jraben/truck-assistant/docs/ev-features.md

# EV in-car display features: wish-list for a DIY Slate dashboard

Researched 2026-11-05. The target build is a touchscreen computer (Pi 5, an N100 mini-PC or an Android head unit) running CarPlay through a Carlinkit dongle, with GPS, add-on cameras, aux relays, a Home Assistant link, and possibly read-only CAN.

## What the Slate gives us (baseline)

- No infotainment screen. A phone mount comes standard, with an optional tablet mount, plus a small driver display, physical HVAC knobs and USB power. ([The Drive](https://www.thedrive.com/news/less-is-more-slate-brings-back-window-cranks-hvac-knobs-and-a-screenless-dash), [Jalopnik](https://www.jalopnik.com/1843154/slate-auto-electric-truck-suv-customizable-design-specs-details/), [Edmunds](https://www.edmunds.com/slate/))
- **No built-in modem.** OTA updates and the Slate app go through your phone. ([Guessing Headlights](https://guessingheadlights.com/?p=1472131), [inkl](https://www.inkl.com/news/slate-s-affordable-ev-truck-has-no-screens-uses-your-phone-for-updates), [TechMyMoney](https://techmymoney.com/2026/09/01/slate-truck-skips-built-in-infotainment-for-your-phone/?amp=1))
- **CAN/OBD access is undocumented.** Forum posts claim Slate said it uses CAN, but I could not confirm that, and no pinout or third-party access policy has been published. Every "NEEDS TRUCK DATA" row below depends on this. ([Slate Forums thread](https://www.slateforums.com/forum/goto/post?id=221167), [AutoGuide on the open accessory platform](https://www.autoguide.com/auto/category/trucks/2027-slate-truck-is-an-open-source-pickup-44619247))
- **Consequence:** SoC, speed, gear, TPMS, motor and battery temperatures, and charging state cannot be read until CAN is confirmed. Without it, we approximate from GPS, an IMU, our own sensors and the Slate phone app (which may offer no API).

### Feasibility key
- **EASY:** software and screen only.
- **NEEDS HARDWARE:** add-on part, with a rough cost.
- **NEEDS TRUCK DATA:** needs CAN or OBD reads, which are unknown on Slate.
- **NOT FEASIBLE:** with the reason.

"Connectivity" means the phone hotspot while driving and home Wi-Fi in the garage. A dedicated LTE modem or hotspot (about $60–150 plus a plan) makes the HA link always-on.

## Feature table

| Feature | Who has it | Slate DIY feasibility | How we'd do it |
|---|---|---|---|
| Charging-aware route planning with arrival SoC | Tesla Trip Planner + Set Arrival Energy ([Basenor](https://www.basenor.com/blogs/news/teslas-set-arrival-energy-feature-is-coming-to-the-app)); Polestar/Volvo Google Maps with SoC target ([Polestar](https://www.polestar.com/us/news/google-maps-guide)); Hyundai/Kia ccNC auto-adds up to 4 stops (EV9, Kona) ([forum](https://www.insideevsforum.com/community/threads/hyundai-kia-navigation-is-gaining-ev-route-planning-functionality-soon.15697)); Rivian, Lucid, Ford, GM native nav | **EASY** with manual SoC entry; **NEEDS TRUCK DATA** for live SoC | ABRP in CarPlay (ABRP supports CarPlay), with SoC typed in or pulled from CAN later |
| Battery preconditioning for DC fast charging | Tesla, Polestar (auto when navigating to a DCFC) ([Polestar manual](https://www.polestar.com/uk/manual/polestar-2/2023/article/1e2c80dd24931039c0a801510d8092e4/)), Rivian, Hyundai/Kia, Ford, GM, Lucid | **NOT FEASIBLE** unless Slate exposes it (it would need CAN *write*, which is out of scope) | Show a "Slate app: precondition?" reminder when the destination is a charger |
| Cabin pre-cool (remote climate) | All of them via their apps | **NEEDS TRUCK DATA / NOT FEASIBLE** for the factory HVAC (knobs); **NEEDS HARDWARE** for a workaround | A relay-driven 12V vent fan, or a sunshade reminder. Real pre-cool depends on Slate's app |
| Energy graphs / consumption app | Tesla Energy app with per-trip graphs ([Not a Tesla App](https://www.notateslaapp.com/news/4005/tesla-updates-energy-app-in-spring-update-202614-custom-trips-pause-and-new-widgets)); Rivian, Ford, Hyundai, Lucid efficiency screens | **NEEDS TRUCK DATA** (kWh); **NEEDS HARDWARE** for an alternative: a 12V/HV shunt is not practical | Log Wh/mi from CAN SoC delta × pack size against GPS distance, and chart it like Tesla's 200-mi graph |
| Trip computer (distance, time, avg speed, elevation) | Everyone | **EASY** (GPS) | GPS track logger with A/B trips, elevation gain/loss, and nightly sync to HA/NAS |
| Sentry / Gear Guard parked camera security | Tesla Sentry ([Engadget](https://www.engadget.com/2019/02/14/tesla-sentry-dog-dashcam-autopilot/)); Rivian Gear Guard with app alerts ([Rivian camping story](https://rivian.com/stories/software-update-camping)); GM/Ford app alerts | **NEEDS HARDWARE**: 2–4 cams ($30–80 each), PIR/radar sensor ($10), low-power standby, LTE for remote alerts | Frigate-style motion detection on the head unit or a low-power SBC, pushed through HA/phone push. Watch the 12V drain |
| Dashcam (rolling loop + save clip) | Tesla (now up to 24h retention per 2026 reports) ([Not a Tesla App](https://www.notateslaapp.com/news/700/the-top-features-in-any-tesla)); Rivian Gear Guard drive recording; Hyundai/Kia built-in cam (some trims) | **NEEDS HARDWARE**: front/rear USB or AHD cams ($60–150) + 256 GB+ SSD ($30) | ffmpeg segment loop, a SAVE button on screen plus a G-sensor trigger from the IMU, and Wi-Fi offload to the NAS at home |
| 360° / bird's-eye camera | Rivian, Ford Lightning, GM, Hyundai/Kia, Lucid, Polestar, Mach-E | **NEEDS HARDWARE**: 4 fisheye cams + stitching box ($200–450 kits), or DIY stitch with OpenCV | Buy an aftermarket 360 kit with composite/AHD output into a capture card. DIY stitching is a stretch goal |
| Trailer camera / transparent trailer | GM Silverado EV transparent trailer and length detection via OTA ([EV Magz](https://evmagz.com/gm-rolls-out-major-software-update-for-silverado-ev-and-sierra-ev-pickups/)); Ford Lightning; Rivian | **NEEDS HARDWARE**: wireless trailer cam ($80–200) | Auto-show the trailer cam on reverse/turn signal (needs a trigger wire or CAN). Transparent overlay is hard, so skip it |
| Hitch assist / hitch guide lines | Ford Pro Trailer Hitch Assist auto-steers ([InsideEVs](https://insideevs.com/news/661483/ford-pro-trailer-hitch-assist-artificial-intelligence/about:blank)); GM, Rivian guide lines | Guide lines: **NEEDS HARDWARE** (a rear cam pointed at the ball, $40). Auto-steer: **NOT FEASIBLE** (needs steering control) | Overlay a static hitch-ball target and dynamic distance lines on the rear cam |
| Onboard scales / payload | Ford F-150/Lightning on-board scales + Smart Hitch tongue weight ([Design News](https://www.designnews.com/automotive-engineering/ford-weighs-advantages-built-scales-2021-f-150)) | **NEEDS HARDWARE**: ride-height sensors ($50–150, calibrated) or a weigh-safe hitch ball ($200+) | Rear-axle ultrasonic/laser height sensor calibrated against CAT-scale readings to give estimated payload |
| Pro Power Onboard / outlet & V2L control | Ford Lightning Pro Power (2.4/9.6 kW); Hyundai/Kia V2L with a minimum-SoC cutoff in settings ([Lectron](https://ev-lectron.com/en-ca/blogs/blog/how-to-use-the-v2l-feature-of-the-hyundai-ioniq-5-with-the-lectron-v2l-adapter)); Rivian outlets, Silverado EV PowerBase, Tesla Cybertruck | Factory outlet: depends on whether Slate offers one (**NEEDS TRUCK DATA**). Aux power: **NEEDS HARDWARE**, a 12V inverter or a portable power station ($300–900) | Relay-switch an inverter, add a power-station BLE/HA integration, and enforce a "don't drain 12V below X" cutoff |
| Aux relay / upfitter switches | Ford upfitter switches, Rivian/GM accessory power controls | **NEEDS HARDWARE**: 4–8 ch relay board or ESPHome/Shelly 12V ($20–60) | On-screen buttons for light bar, bed lights, compressor and fridge. Each one is an HA entity too |
| Tow mode & trailer profiles | GM Trailering app (profiles, checklists, maintenance, theft alerts) ([Chevrolet](https://www.chevrolet.com/electric/silverado-ev/intuitive-technology)); Rivian tow mode in off-road modes ([Green Car Reports](https://www.greencarreports.com/news/1141137_rivian-evs-software-update-makes-towing-an-all-terrain-experience)); Ford | Profiles/checklist: **EASY**. Range-while-towing correction: **NEEDS TRUCK DATA** for accuracy | Per-trailer profile (weight, length, tire PSI, pre-trip checklist) that applies a range multiplier to the route plan |
| Camp mode | Tesla Camp Mode ([dubizzle](https://www.dubizzle.com/blog/cars/tesla-camp-mode/)); Rivian Camp Mode with leveling, outlet timers, display off, "camp courtesy" ([CleanTechnica](https://cleantechnica.com/2022/08/31/rivians-new-camp-mode-levels-your-truck-helps-in-other-ways/)); Hyundai Utility Mode ([AutoRoamer](https://www.autoroamer.com/posts/hyundai-ioniq-5-camping-guide.html)) | **EASY** for software; **NEEDS HARDWARE** for an IMU ($10) + relays | One tap: dim/blank the screen, turn bed lights and fridge on, show a level bubble from the IMU, run a 12V drain timer and silence chimes |
| Pet / dog mode | Tesla Dog Mode; Rivian Pet Comfort with on-screen message ([Drive Tesla](https://driveteslacanada.ca/?p=53827)); Hyundai/Kia, Ford | Display + sensor: **NEEDS HARDWARE** (cabin temp sensor $5–15). Holding A/C: **NEEDS TRUCK DATA** (it would need Slate HVAC to run while parked) | Full-screen "Dog is fine, it's 74°F inside" plus a cabin-temperature push to the phone via HA. Phoenix: alert at >85°F |
| Cabin overheat protection / cabin temp alert | Tesla Cabin Overheat Protection; Rivian | **NEEDS HARDWARE**: temp sensor ($5) + LTE for alerts | HA automation: cabin >120°F gives a phone push, and a relay can run a vent fan. A child/pet-left-behind reminder via seat or PIR sensor |
| Games while parked | Tesla Arcade with BT controllers ([Not a Tesla App](https://www.notateslaapp.com/news/700/the-top-features-in-any-tesla)); Polestar/Volvo and GM via Google Play; Rivian | **EASY** (Android/Linux apps, Moonlight game stream from the house) | Parked-only launcher tile gated on GPS speed = 0 and park |
| Theater / streaming while parked | Tesla Theater ([Not a Tesla App](https://www.notateslaapp.com/news/700/the-top-features-in-any-tesla)); Ford (YouTube, karaoke) ([Benzinga](https://benzinga.com/z/40920761)); GM/Polestar Google Play; Rivian, Lucid, Hyundai/Kia (some trims) | **EASY** (needs Wi-Fi or a hotspot) | Plex/Jellyfin from the NAS (pre-download for offline), YouTube. Lock out while moving |
| Karaoke | Ford Lightning/Mach-E Connectivity package ([Benzinga](https://benzinga.com/z/40920761)); Tesla Caraoke | **EASY** (an app); a mic adds **NEEDS HARDWARE** ($20) | Low priority. A browser karaoke page or a Jellyfin lyrics overlay |
| Web browser | Tesla, Rivian, Lucid; GM/Polestar via apps | **EASY** | Chromium kiosk tab, parked only |
| Voice assistant | Polestar/Volvo/GM Google Assistant or Gemini ([Polestar](https://www.polestar.com/en-ca/polestar-4/technology/)); Ford Alexa ([Benzinga](https://benzinga.com/z/40920761)); Tesla, Rivian, Lucid (Alexa), Hyundai/Kia native | **EASY**: Siri through CarPlay for free; a WOPR/HA assist voice needs a mic ($20) | Wake word gives HA Assist / WOPR ("open the garage", "is the back door locked", "what's the gate code here") |
| Driver profiles | Tesla, Rivian, Lucid, Polestar, Ford, GM, Hyundai/Kia (seat, mirrors, climate, nav favorites) | Screen prefs: **EASY**. Seat/mirror memory: **NOT FEASIBLE** (Slate has manual seats and crank-style basics) | Profile picks the layout, favorites, CarPlay phone and EQ. Auto-select by which phone's BT connects |
| Light shows / easter eggs | Tesla Light Show (Toybox, custom USB shows) ([Not a Tesla App](https://www.notateslaapp.com/news/2422/photos-and-video-of-teslas-holiday-update-2024-part-1)); Rivian, Lucid welcome animations | Factory lights: **NOT FEASIBLE** (no CAN write). Add-on lights: **NEEDS HARDWARE**, addressable LED strips + ESP32 ($30–80) | WLED bed/rock lights synced to music, and a "welcome home" HA scene |
| Off-road screen: pitch/roll inclinometer | Rivian Gauge View with pitch/roll, torque, steering angle, tire pressure ([Green Car Reports](https://www.greencarreports.com/news/1141137_rivian-evs-software-update-makes-towing-an-all-terrain-experience)); Ford, GM, Hyundai/Kia (some) | **NEEDS HARDWARE**: IMU, BNO085/MPU-6050 ($10–30) | Pitch/roll gauges with red limit lines, compass, altitude and GPS breadcrumbs for trail-back. A big win for little money |
| Tire pressure (TPMS) | Everyone (Rivian, Ford, GM show per-tire values) | **NEEDS TRUCK DATA** for factory sensors, *or* **NEEDS HARDWARE**: BLE TPMS caps/sensors ($40–80) | BLE TPMS decoded in software, with per-tire PSI and temperature (Phoenix pavement heat) and alerts |
| Scheduled charging / TOU rates | Tesla, Rivian, Ford, GM, Hyundai/Kia, Polestar (in car + app) | Truck-side: **NEEDS TRUCK DATA / Slate app**. EVSE-side: **EASY** if the home charger is in HA | Schedule the *charger* from HA (SRP/APS off-peak windows) and show "charging starts 9 pm" on the dash |
| Remote app (status, lock, climate) | All OEMs | Status: **NEEDS HARDWARE** (always-on LTE + low-power monitor). Lock/climate: **NOT FEASIBLE** without CAN write | The HA dashboard becomes the "truck app": GPS location, cabin temp, 12V voltage, camera snapshot, relay control |
| GPS tracking / geofence | All OEM apps | **NEEDS HARDWARE**: GPS (already planned) + LTE for live tracking | Truck device tracker in HA. Geofence triggers the garage door and the "arrived at a job site" gate code (WOPR /api/where) |
| OTA updates | Tesla, Rivian, Lucid, Polestar, GM, Ford Power-Up, Hyundai/Kia. Slate does OTA through the phone ([inkl](https://www.inkl.com/news/slate-s-affordable-ev-truck-has-no-screens-uses-your-phone-for-updates)) | **EASY** for our own software | Head unit pulls its own update from GitHub/NAS when on home Wi-Fi, with A/B rollback. Slate's own OTA stays on the phone |
| Home Assistant / smart home integration | Rivian, Tesla, Ford via 3rd-party HA integrations; Google built-in (Polestar/GM) smart-home control | **EASY** (the main differentiator here) | Garage, gate, alarm, front-door cam on the dash, HA presence, and "leaving home" checks (doors locked? oven off?) |
| Phone as key / walk-away lock | Tesla, Rivian, Ford Mach-E, Hyundai/Kia digital key | **NOT FEASIBLE** (needs body-control integration) | Skip. At most a walk-away reminder: phone BT drops while the truck is unlocked |
| 12V battery monitor | Rare on screen (Rivian shows 12V faults) | **NEEDS HARDWARE**: voltage divider/INA226 ($5–15) | Show 12V volts, auto-shutdown the head unit below 12.1V, and alert via HA |
| Charging station finder + live availability | Everyone native; Slate app does charger search ([inkl](https://www.inkl.com/news/slate-s-affordable-ev-truck-has-no-screens-uses-your-phone-for-updates)) | **EASY** via CarPlay (PlugShare, ChargePoint, ABRP) | CarPlay apps, plus a "nearest DCFC / mi of range left" widget once SoC is known |
| Speed-limit / ADAS display | Tesla, Ford BlueCruise, GM Super Cruise, Hyundai/Kia HDA | Display: **EASY** (from CarPlay maps). ADAS: **NOT FEASIBLE** | Leave it to Waze/Apple Maps in CarPlay |

## Top 10 to steal (ranked for a Phoenix owner who runs Home Assistant)

1. **Cabin heat alarm + pet/kid screen**: cabin temp push via HA, a "dog is fine, 74°F" screen and a vent-fan relay. *NEEDS HARDWARE* (~$20 sensor, LTE for remote alerts). Holding A/C needs truck data.
2. **HA command center on the dash**: garage/gate, house cams, "leaving home" checks, gate code on arrival (WOPR). *EASY*.
3. **Dashcam + parked Sentry**: loop recording, on-screen SAVE, motion alert to the phone. *NEEDS HARDWARE* (~$150–300 cams + SSD, LTE).
4. **Charge-aware route planning (ABRP in CarPlay) with arrival SoC.** *EASY* with typed SoC, *NEEDS TRUCK DATA* for live SoC.
5. **TPMS with tire temperature** (Phoenix asphalt plus towing). *NEEDS HARDWARE* (~$50 BLE sensors).
6. **Camp mode + off-road inclinometer**: IMU level bubble, pitch/roll, screen-off, relay scenes. *NEEDS HARDWARE* (~$15 IMU + $40 relays).
7. **Aux relay / upfitter switches + power-station control** (lights, fridge, inverter, with a 12V cutoff). *NEEDS HARDWARE* (~$40–60).
8. **Scheduled off-peak charging via HA** (SRP/APS TOU) with "starts 9 pm" on the dash. *EASY* if the EVSE is in HA; truck-side *NEEDS TRUCK DATA*.
9. **Trip computer + energy/efficiency log** (GPS trips now, Wh/mi once CAN exists). *EASY* for the trip half, *NEEDS TRUCK DATA* for the energy half.
10. **Trailer profiles + trailer cam + hitch guide lines.** *EASY* for profiles; *NEEDS HARDWARE* for cams (~$40–200).

Honourable mentions: parked-only Plex/Jellyfin theater and Moonlight games (*EASY*), and WLED light show (*NEEDS HARDWARE*, ~$50).

## Caveats
- Several sources are fan sites, forums and dealer pages, so features vary by model year, trim and software version. Tesla's 24-hour dashcam retention and the Hyundai/Kia "4 auto stops" claim rest on single sources.
- Slate's CAN access is unconfirmed. Treat every NEEDS TRUCK DATA row as phase 2.
- 12V drain is the hidden cost of every "parked" feature (Sentry, camp, pet). Size a separate aux battery (LiFePO4 + DC-DC, ~$200–400) if parked features matter.
