jraben/truck-assistant/docs/brand/truck-assistant/preview.png

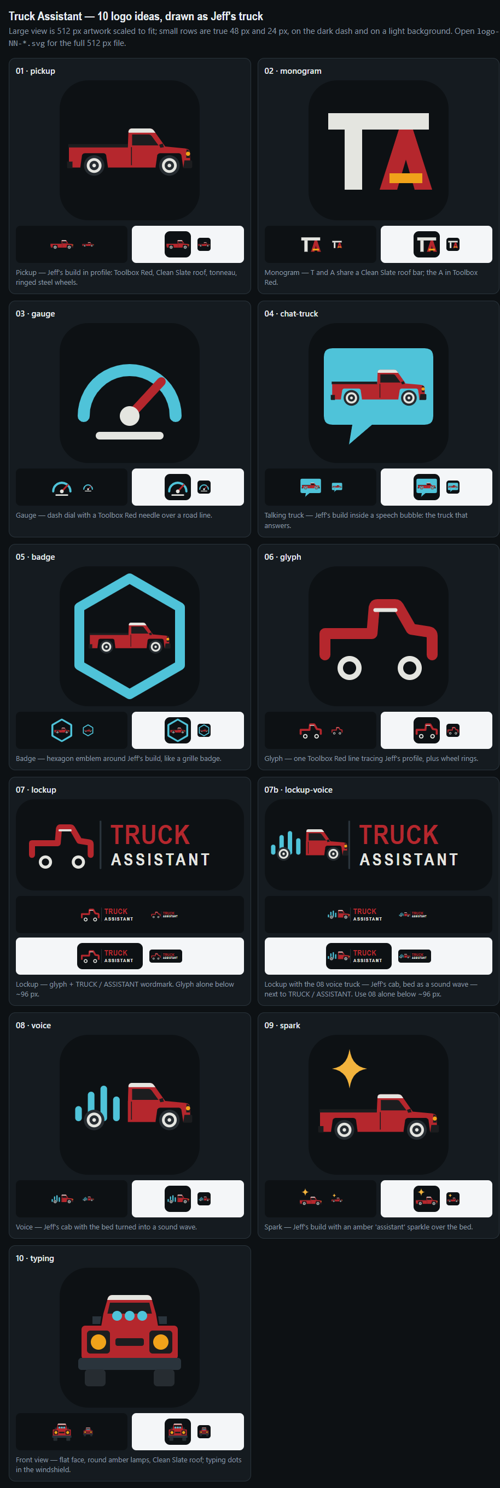
docs/brand/truck-assistant/preview.png
