jraben/truck-assistant/print/brain-enclosure/stl/logo_white.stl

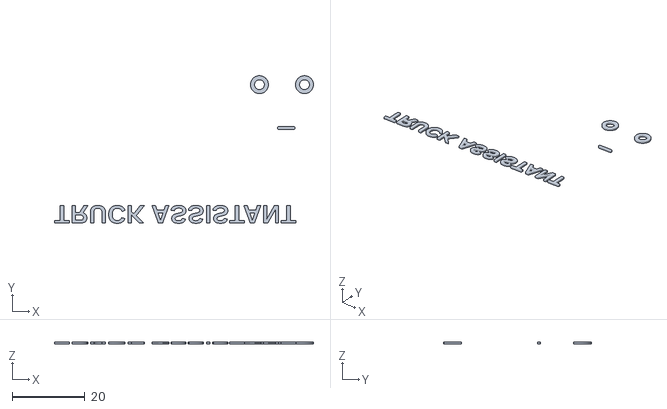
[picture p3: CAD file, 2026-11-13]
print/brain-enclosure/stl/logo_white.stl
71.0 x 40.5 x 0.6
