jraben/truck-assistant/print/cam-bracket/stl/base.stl

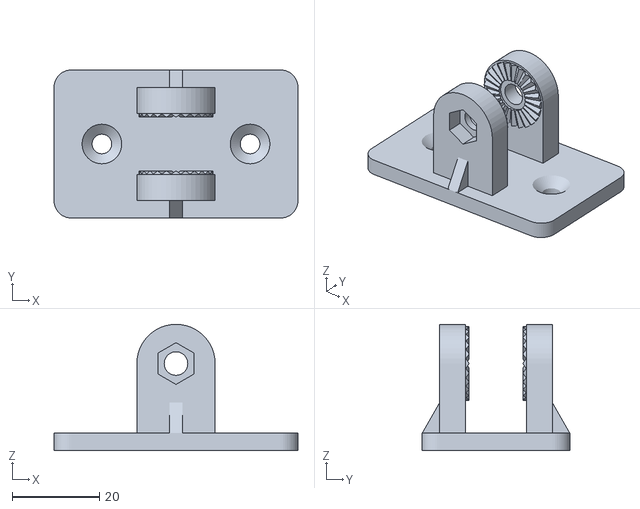
[picture p4: CAD file, 2026-11-05]
print/cam-bracket/stl/base.stl
56.0 x 34.0 x 29.0
