jraben/truck-assistant/print/dash-bar-insert/stl/hood_right.stl

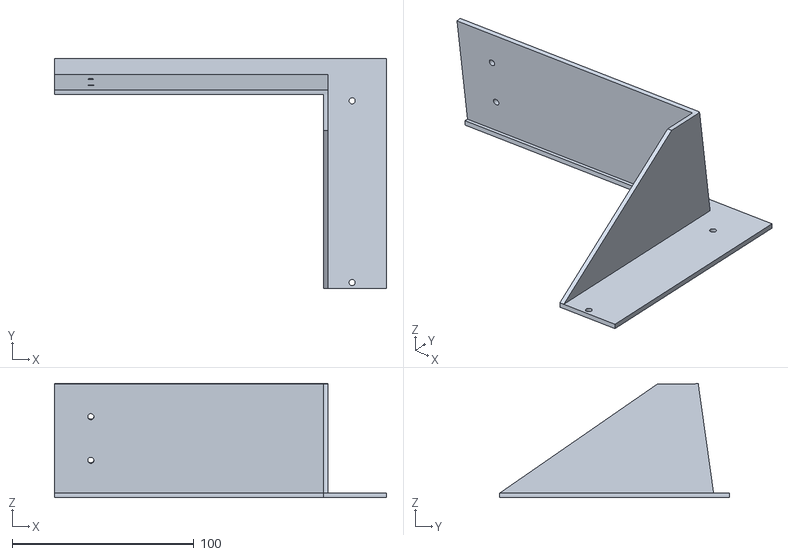
[picture p5: CAD file, 2026-11-05]
print/dash-bar-insert/stl/hood_right.stl
182.7 x 126.3 x 62.8
