jraben/truck-assistant/print/hitch-cam-mount/stl/strap.stl

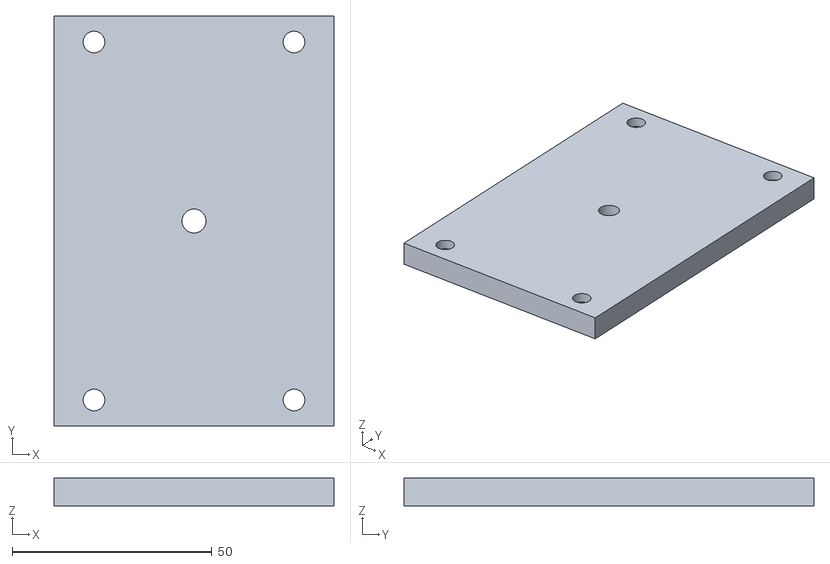
[picture p6: CAD file, 2026-11-05]
print/hitch-cam-mount/stl/strap.stl
70.0 x 102.5 x 7.00
