jraben/truck-assistant/print/service-kit/stl/loom_clip.stl

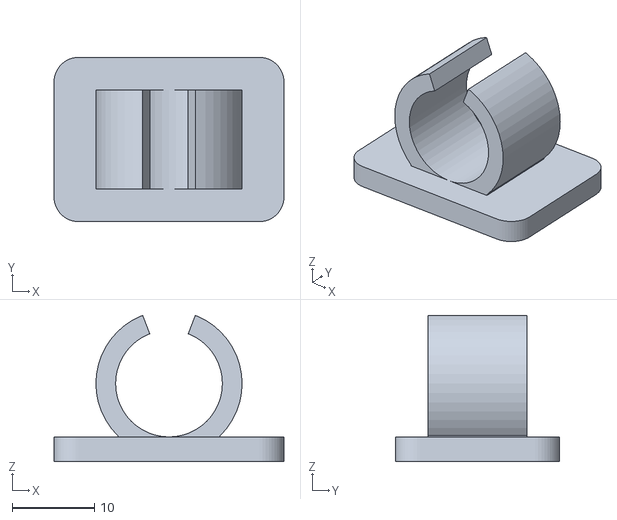
[picture p7: CAD file, 2026-11-06]
print/service-kit/stl/loom_clip.stl
28.0 x 20.0 x 17.8
