jraben/truck-assistant/print/brain-enclosure/stl/logo_red.stl

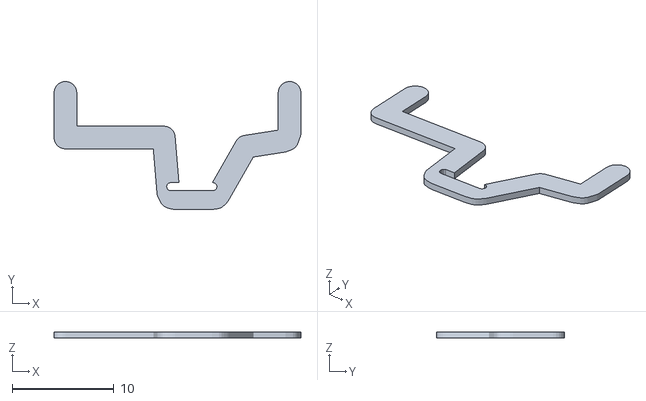
[picture p8: CAD file, 2026-11-13]
print/brain-enclosure/stl/logo_red.stl
24.2 x 12.6 x 0.6
