jraben/truck-assistant/print/cam-bracket/stl/arm.stl

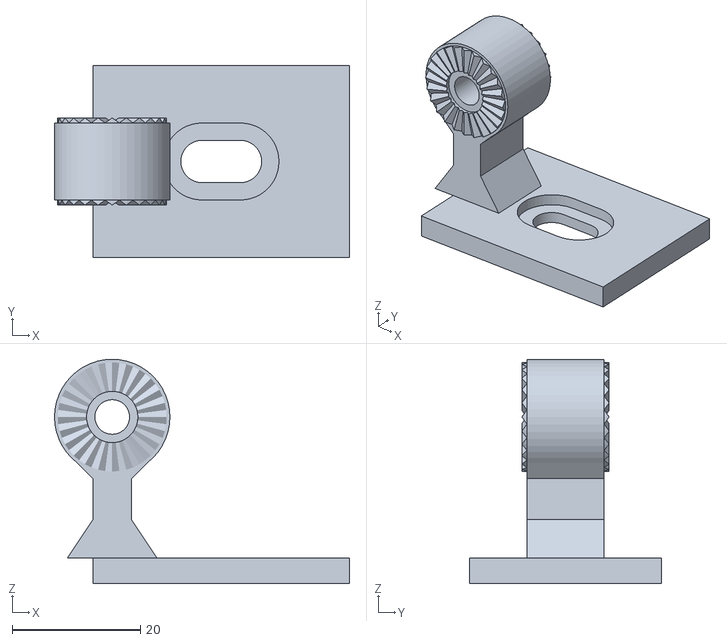
[picture p9: CAD file, 2026-11-05]
print/cam-bracket/stl/arm.stl
46.0 x 30.0 x 35.0
