jraben/truck-assistant/print/hitch-cam-mount/stl/collar.stl

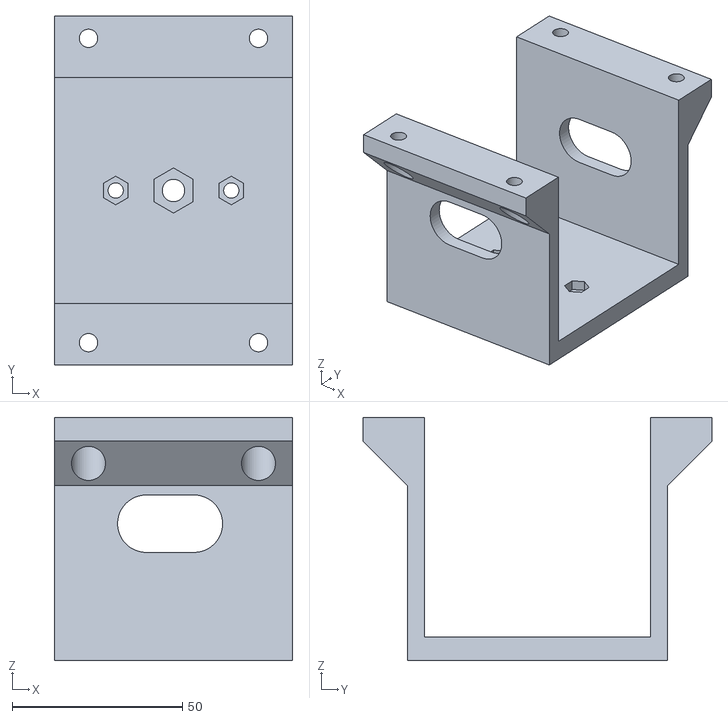
[picture p10: CAD file, 2026-11-05]
print/hitch-cam-mount/stl/collar.stl
70.0 x 102.5 x 71.5
