jraben/truck-assistant/print/service-kit/stl/dt_bracket.stl

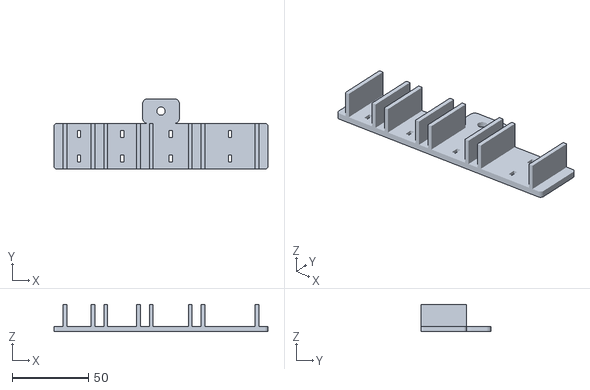
[picture p11: CAD file, 2026-11-06]
print/service-kit/stl/dt_bracket.stl
140.2 x 46.0 x 18.0
