jraben/truck-assistant/print/brain-enclosure/stl/lid.stl

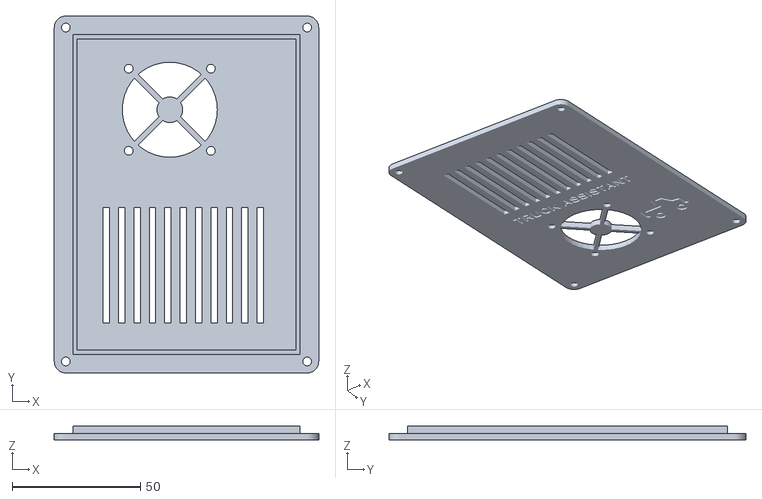
[picture p12: CAD file, 2026-11-13]
print/brain-enclosure/stl/lid.stl
103.0 x 139.0 x 5.49
