jraben/truck-assistant/print/dash-bar-insert/stl/bezel_left.stl

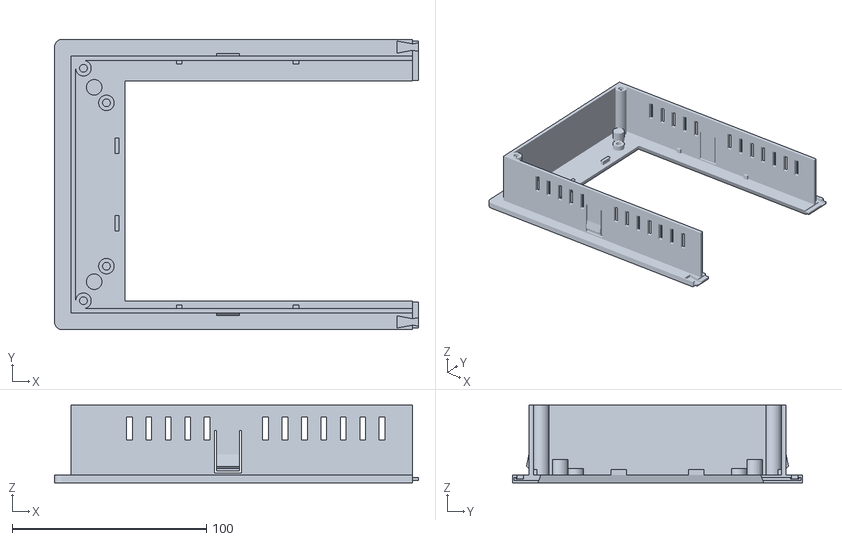
[picture p13: CAD file, 2026-11-05]
print/dash-bar-insert/stl/bezel_left.stl
187.2 x 149.3 x 40.0
