jraben/truck-assistant/print/brain-enclosure/stl/box.stl

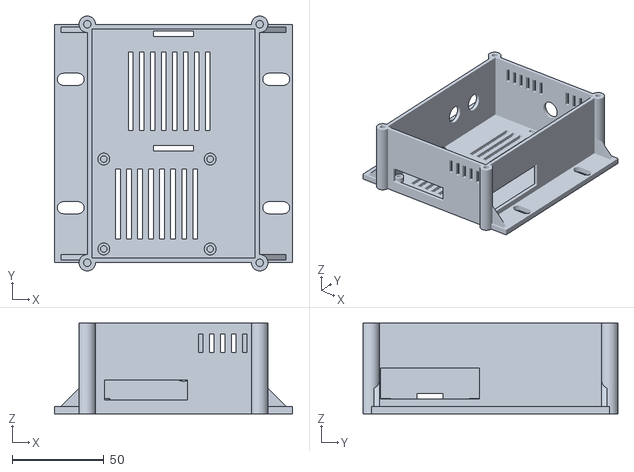
[picture p14: CAD file, 2026-11-05]
print/brain-enclosure/stl/box.stl
130.0 x 139.0 x 49.5
