jraben/truck-assistant/print/dash-bar-insert/stl/hood_splice.stl

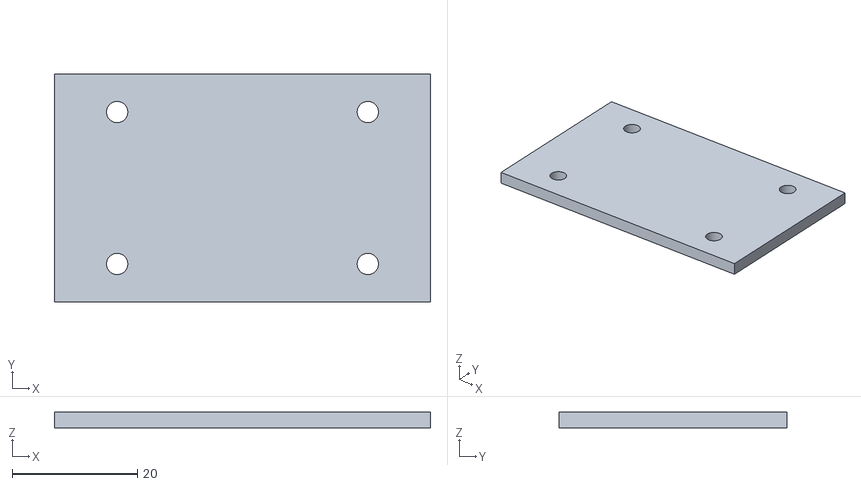
[picture p15: CAD file, 2026-11-05]
print/dash-bar-insert/stl/hood_splice.stl
60.0 x 36.4 x 2.50
