jraben/truck-assistant/print/service-kit/stl/rail.stl

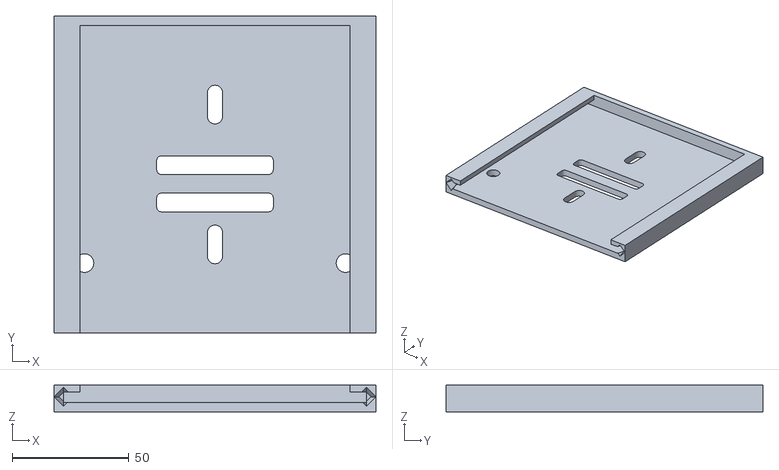
[picture p16: CAD file, 2026-11-06]
print/service-kit/stl/rail.stl
138.0 x 136.0 x 11.5
