jraben/truck-assistant/print/dash-bar-insert/stl/bezel_right.stl

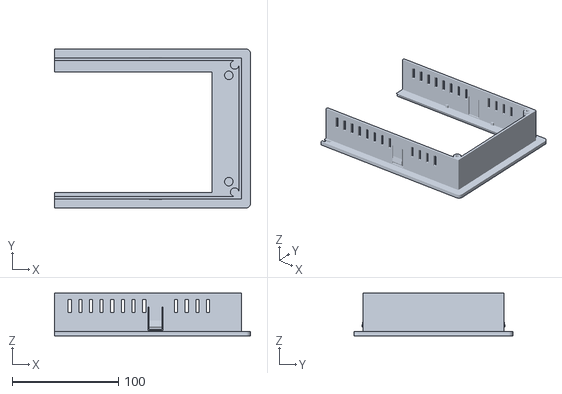
[picture p17: CAD file, 2026-11-05]
print/dash-bar-insert/stl/bezel_right.stl
184.2 x 149.3 x 40.0
