jraben/truck-assistant/print/service-kit/stl/dock.stl

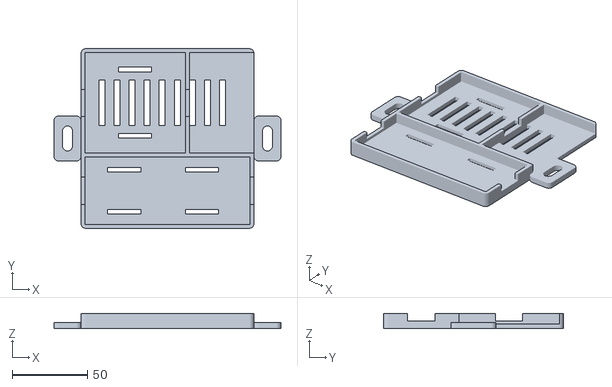
[picture p18: CAD file, 2026-11-06]
print/service-kit/stl/dock.stl
151.0 x 119.5 x 10.0
