jraben/truck-assistant/print/dash-bar-insert/stl/cover_left.stl

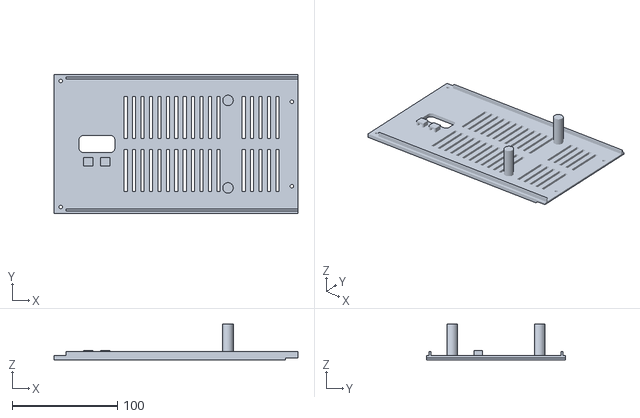
[picture p19: CAD file, 2026-11-05]
print/dash-bar-insert/stl/cover_left.stl
231.5 x 132.3 x 34.0
