jraben/truck-assistant/print/dash-bar-insert/stl/key.stl

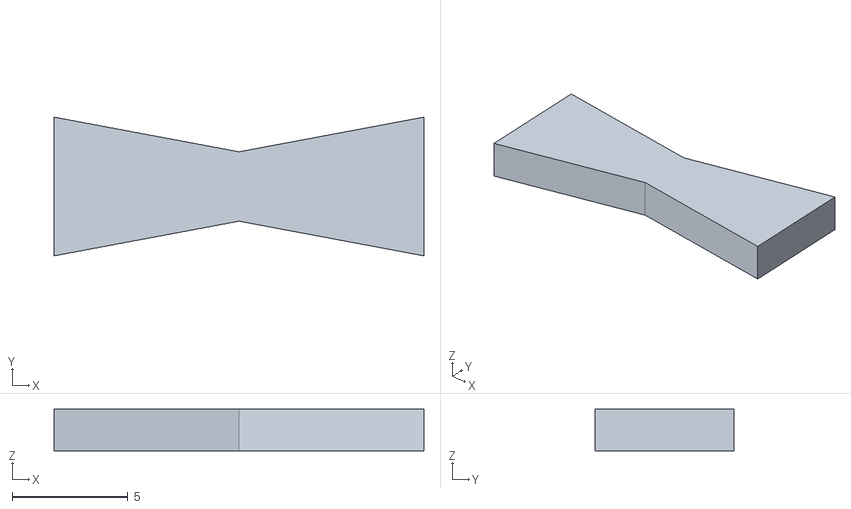
[picture p20: CAD file, 2026-11-05]
print/dash-bar-insert/stl/key.stl
16.0 x 6.00 x 1.80
