jraben/truck-assistant/print/dash-bar-insert/stl/fit_test.stl

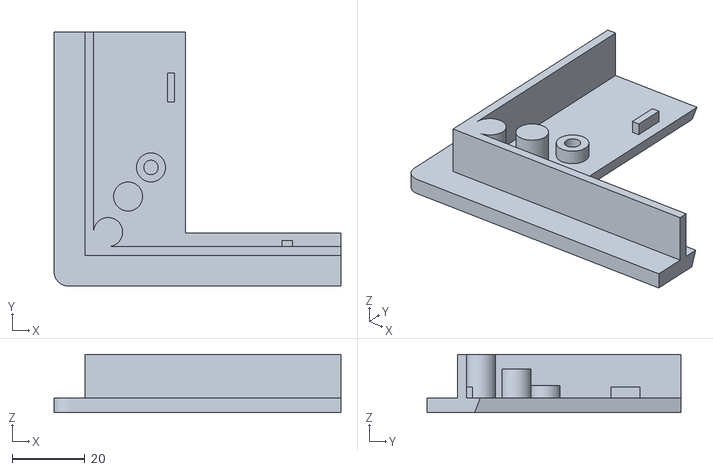
[picture p21: CAD file, 2026-11-05]
print/dash-bar-insert/stl/fit_test.stl
79.0 x 70.0 x 16.0
