jraben/truck-assistant/print/dash-bar-insert/stl/tab.stl

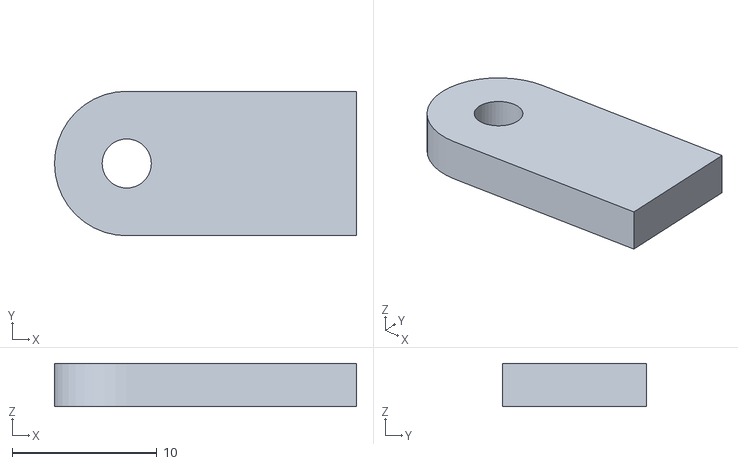
[picture p22: CAD file, 2026-11-05]
print/dash-bar-insert/stl/tab.stl
20.9 x 10.0 x 3.00
