jraben/truck-assistant/print/dash-bar-insert/stl/cover_right.stl

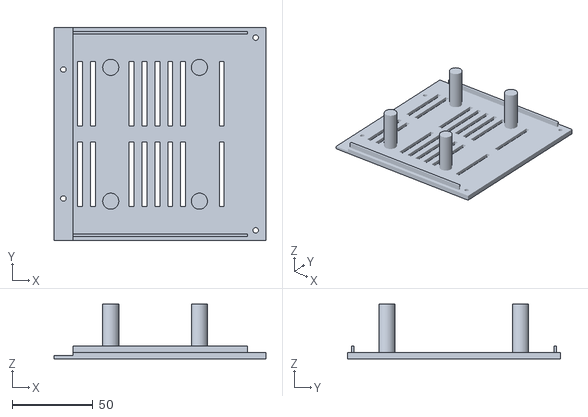
[picture p23: CAD file, 2026-11-05]
print/dash-bar-insert/stl/cover_right.stl
131.5 x 132.3 x 34.0
