jraben/truck-assistant/(list of files, cad)

Other CAD files:
print/dash-bar-insert/stl/hood_left.stl
print/service-kit/stl/loom_clip_screw.stl
