jraben/truck-assistant/print/brain-enclosure/stl/box.png

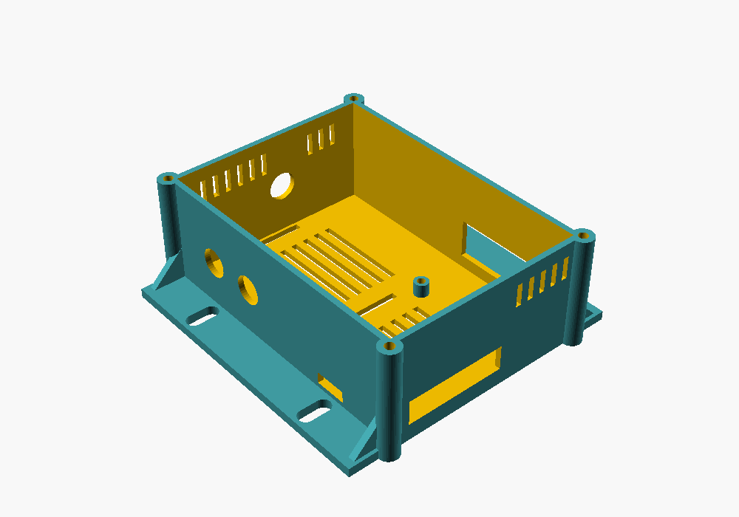
print/brain-enclosure/stl/box.png
