jraben/truck-assistant/print/brain-enclosure/stl/lid.png

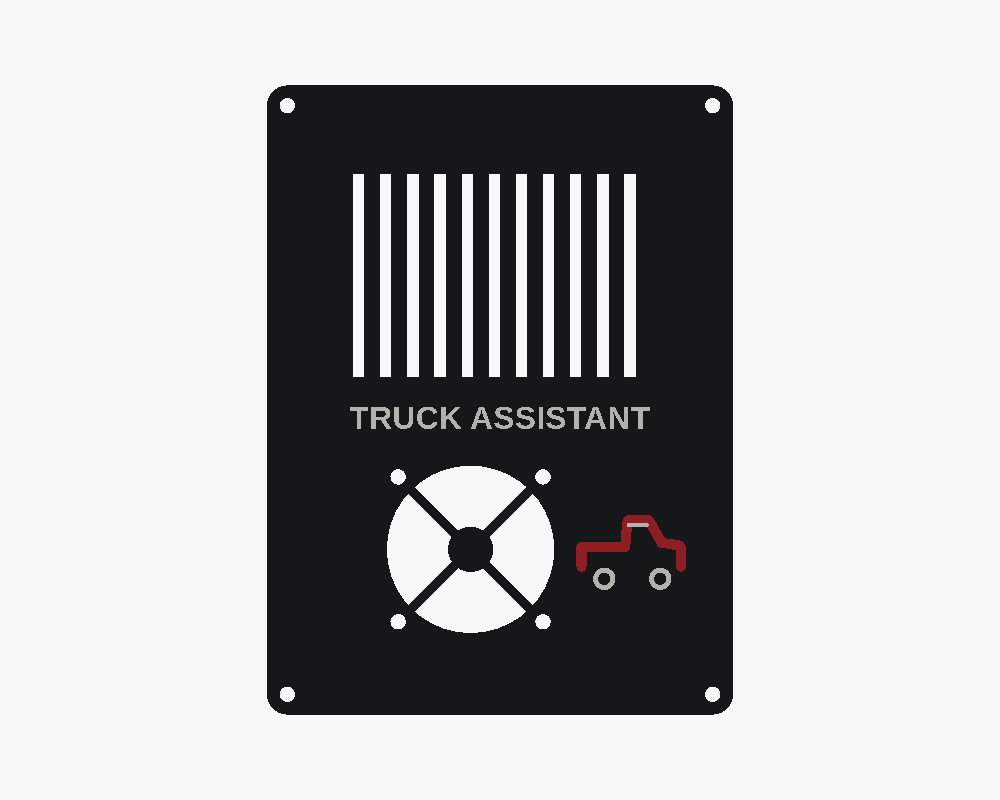
print/brain-enclosure/stl/lid.png
