jraben/truck-assistant/print/cam-bracket/stl/arm.png

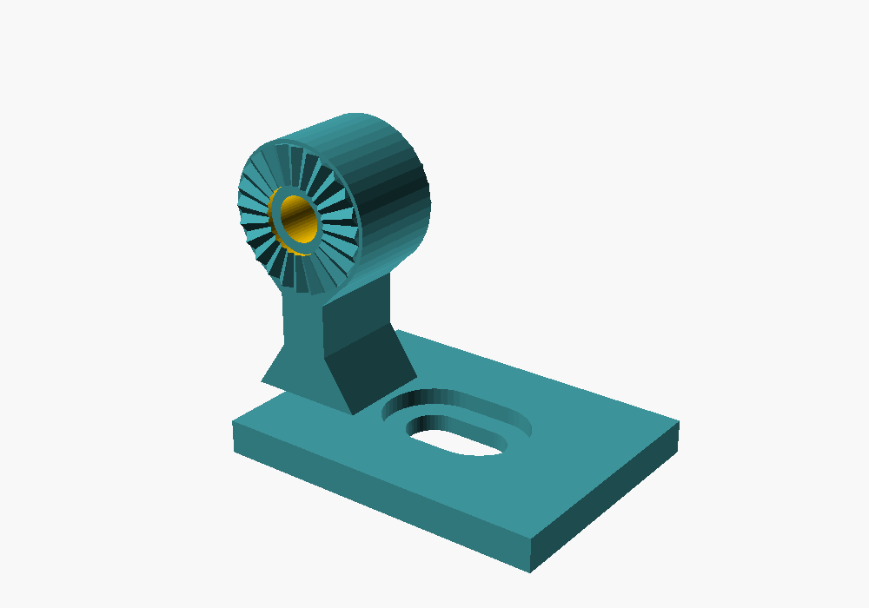
print/cam-bracket/stl/arm.png
