jraben/truck-assistant/print/cam-bracket/stl/base.png

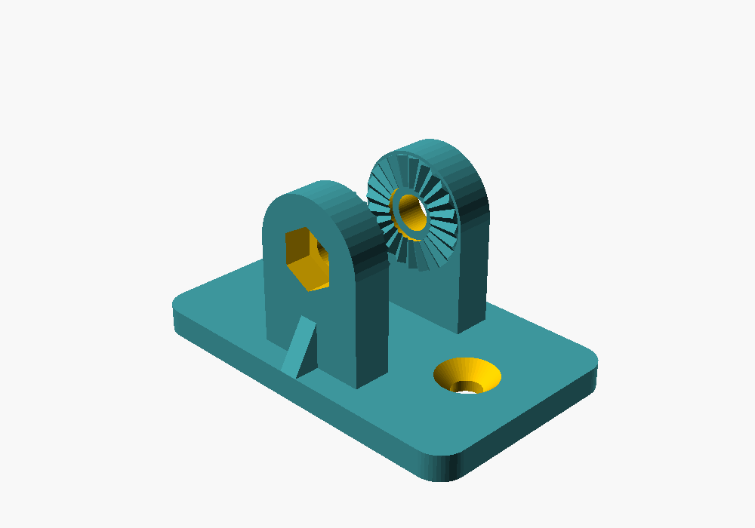
print/cam-bracket/stl/base.png
