jraben/truck-assistant/print/dash-bar-insert/stl/assembly-front.png

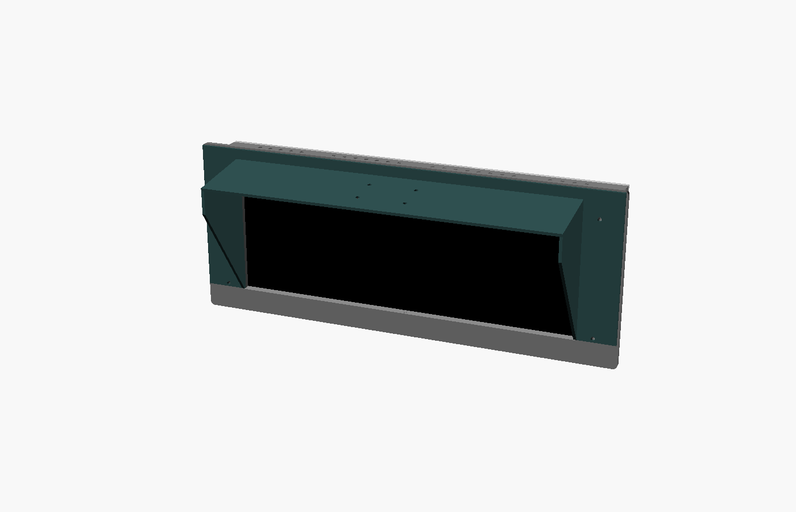
print/dash-bar-insert/stl/assembly-front.png
