jraben/truck-assistant/print/dash-bar-insert/stl/assembly-rear.png

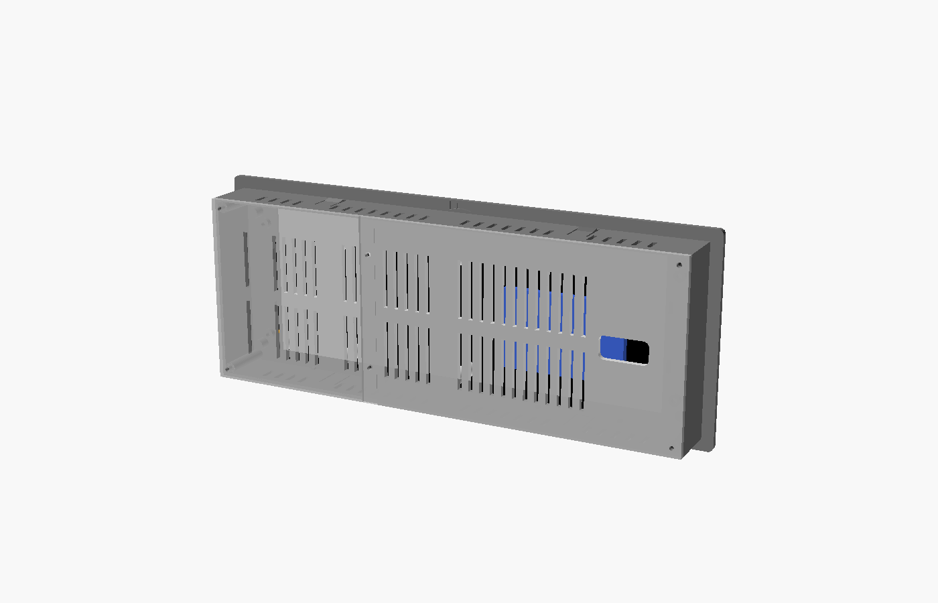
print/dash-bar-insert/stl/assembly-rear.png
