jraben/truck-assistant/print/dash-bar-insert/stl/bezel_left.png

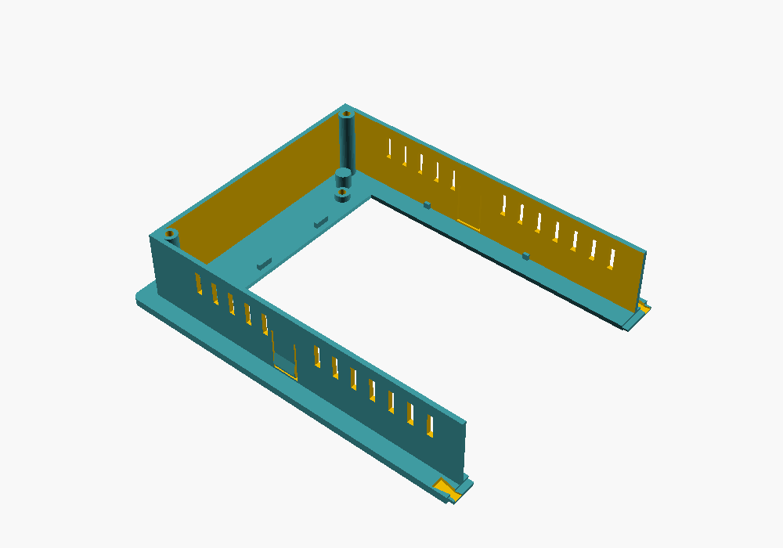
print/dash-bar-insert/stl/bezel_left.png
