jraben/truck-assistant/print/dash-bar-insert/stl/cover_left.png

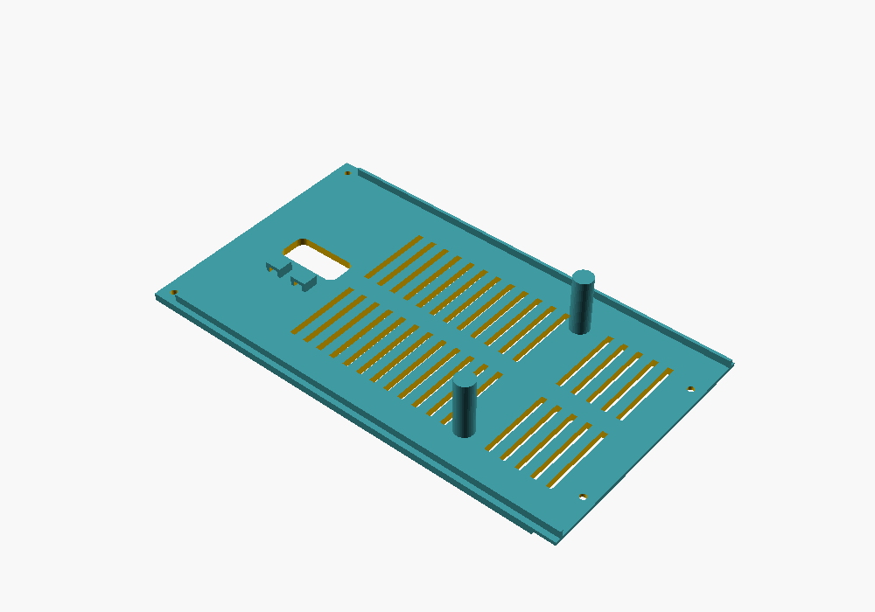
print/dash-bar-insert/stl/cover_left.png
