jraben/truck-assistant/print/dash-bar-insert/stl/hood_right.png

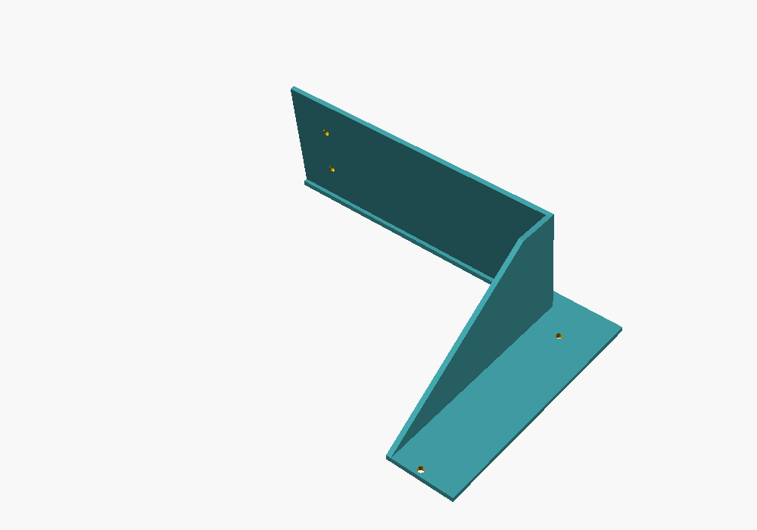
print/dash-bar-insert/stl/hood_right.png
