jraben/truck-assistant/print/hitch-cam-mount/stl/collar.png

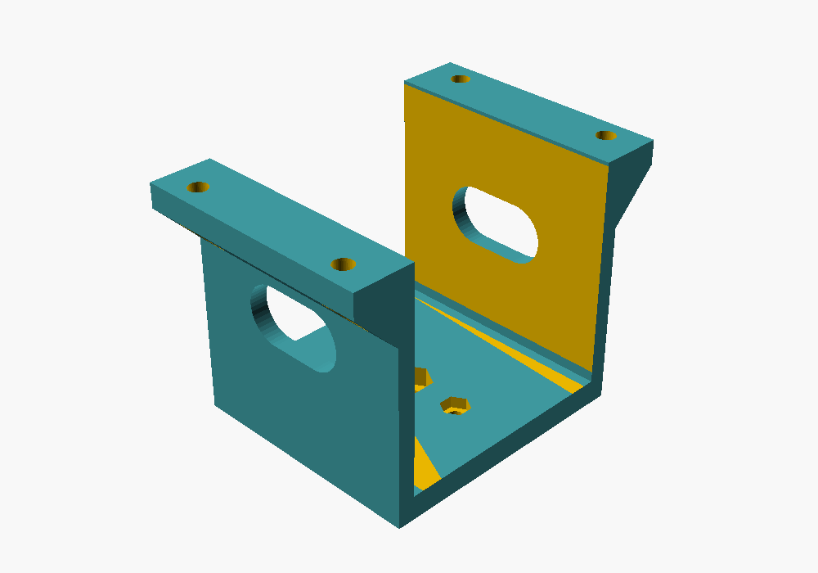
print/hitch-cam-mount/stl/collar.png
