jraben/truck-assistant/print/service-kit/stl/dock.png

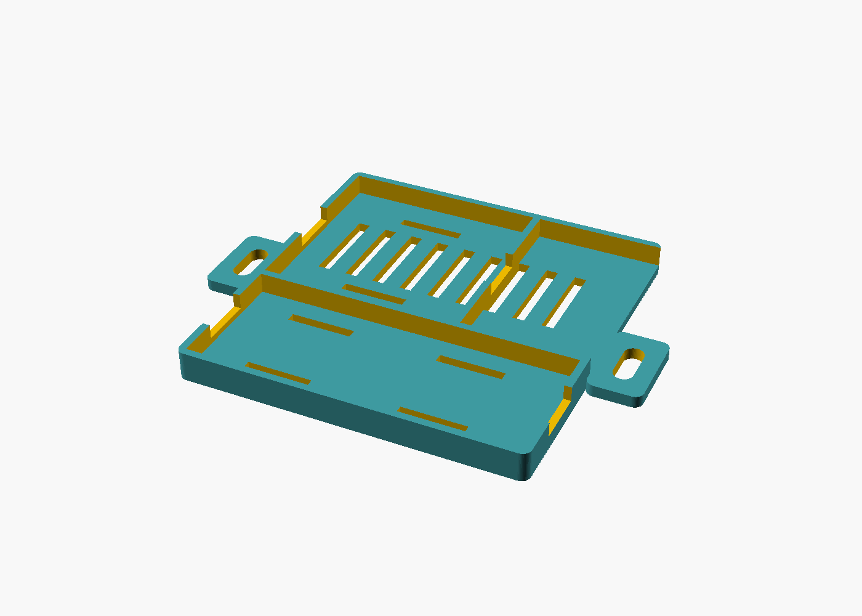
print/service-kit/stl/dock.png
