jraben/truck-assistant/print/service-kit/stl/dt_bracket.png

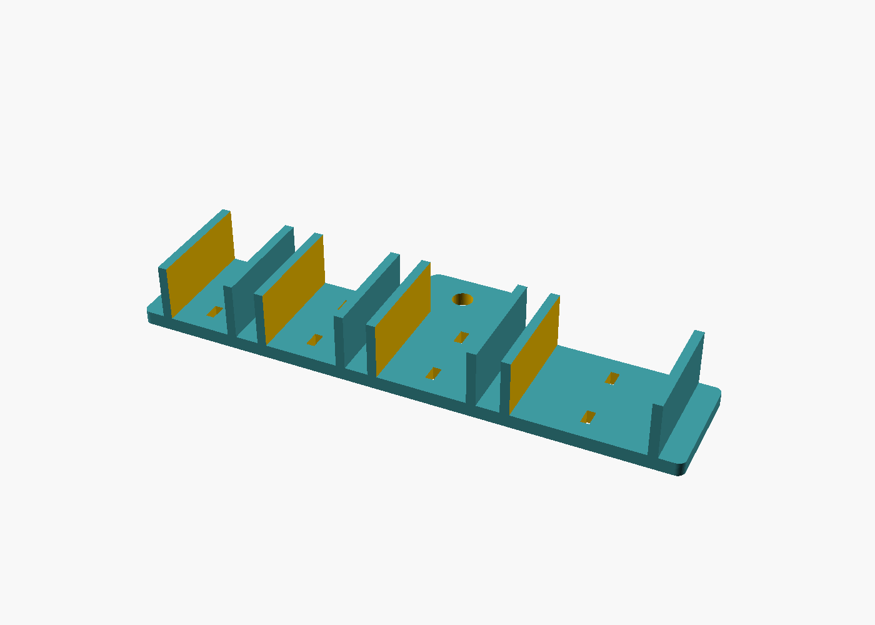
print/service-kit/stl/dt_bracket.png
