jraben/truck-assistant/print/service-kit/stl/loom_clip.png

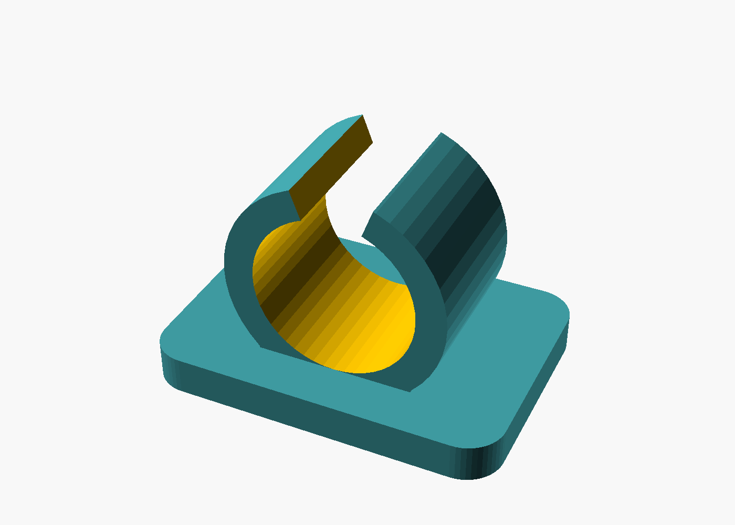
print/service-kit/stl/loom_clip.png
