jraben/truck-assistant/print/service-kit/stl/rail.png

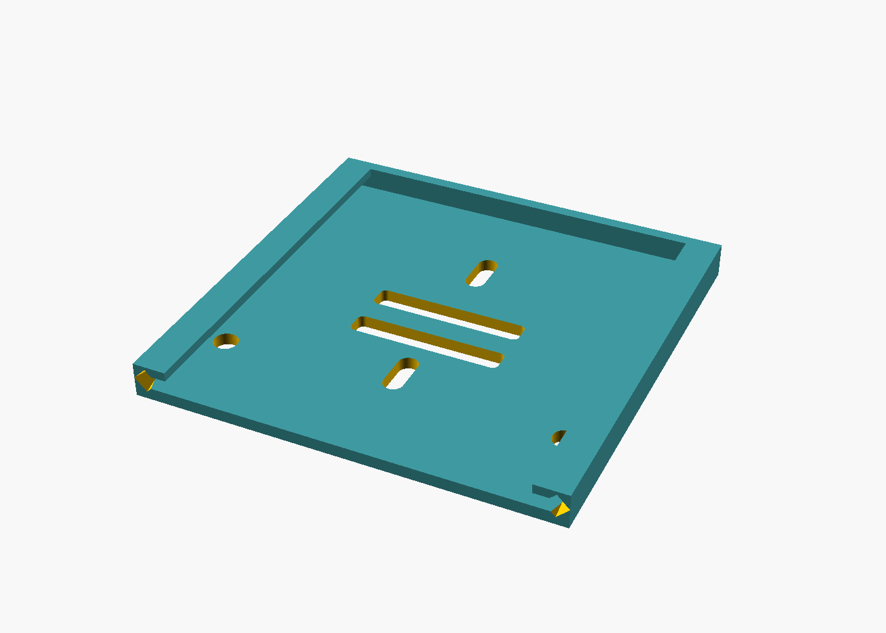
print/service-kit/stl/rail.png
