jraben/truck-assistant/(commit log)

2026-11-05 Slate Cockpit: prototype UI, three hardware plans, EV feature survey, options comparison
2026-11-05 Pick the Pi brain + two-screen path; add Slate forum findings
    Android head unit ruled out. Print rule: ASA on the dash, no PETG.
    Adds the 12.3in bar-screen dash insert to the print list.
2026-11-05 Main screen: 12.3in 1920x720 bar in a dash opening; bar layout in prototype
2026-11-05 Software core, truck box firmware, printable parts
    - brain/: Node 24 service per docs/contract.md (MQTT, gpsd, trips, charger
    finder, charge-cost tracking with TOU home pricing, themes, HA discovery,
    SIM mode), 62 unit tests
    - ui/: Preact cockpit for the 12.3in 1920x720 bar + /settings portal
    - deploy/pi/: systemd, kiosk, Mosquitto bridge template, install.sh
    - firmware/truckbox/: ESPHome for an ESP32 8-relay board (6 relays, Five
    Switch/ignition/reverse sense, cabin temp, 12V, tilt, BLE TPMS); compiles
    - print/: OpenSCAD dash insert + hood, cam bracket, hitch cam mount, Pi
    enclosure, with STLs and previews
    - @fastify/static 10.x (audit: 0 vulnerabilities)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
    [arm.stl, base.stl, bezel_left.stl, bezel_right.stl, box.stl, brain-enclosure.scad, cam-bracket.scad, collar.stl]
2026-11-05 Embed CarPlay in the cockpit (WebUSB + WebCodecs), now-playing to HA
    - ui/src/carplay: worker owns the Carlinkit dongle via vendored node-carplay
    4.1.0 (MIT); H.264 via WebCodecs, PCM via AudioWorklet with ducking, mic for
    Siri/calls, touch mapping, reconnect with backoff
    - now playing: Drive widget, CarPlay strip, State.nowPlaying, HA sensor
    - ?carplaySim=1 simulator with a generated test clip
    - deploy/pi: Chromium WebUSB/mic/autoplay policy, udev rule, README
    - docs/drivers-and-stops.md: design for driver profiles, stops, phone history
    Untested with a real dongle (none here); see deploy/pi/README.md checklist.
2026-11-05 Driver profiles, stops, phone-history import, gas prices, hotspot networking
    - drivers: per-driver theme/layout/charging/tracker/hotspot, presence-based
    suggestion, settings migration with backup
    - stops: detection + naming chain (places, HA zones, places feed, Nominatim),
    tap-to-name, Trips day/trips/places tabs, HA Current place sensor
    - phone history import from HA recorder as a background job
    - gas: GasBuddy sensors via HA, per-day prices, EPA comparison vehicle
    (fueleconomy.gov), city/highway-ready math
    - network: nmcli wrapper, driver hotspot priority, link status strip
    - docs: roadmap, remote access design, connectivity; truck box AP renamed
    slate-truck to match
    Co-Authored-B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
2026-11-05 Track A brain: range modes, since-charge, weather, speed limits, lockout, heat, brightness
2026-11-05 Track C brain: cameras (go2rtc config + desk ffmpeg fallback), dashcam loop and clips, alerts, theft, tier 2 sleep, remote API
2026-11-05 Track B brain: media sources, WOPR voice/calendar/gate, charging receipts
    Now playing from many reporters (CarPlay, the Media view's player, Spotify
    Connect) through one hub; State.nowPlaying.source widens. Radio Browser
    search + ICY relay, Spotify PKCE + Web API + librespot, Plex relay, local
    files, RTL-SDR AM/FM. WOPR STT/chat/TTS proxies with a truck primer,
    next appointment from /api/calendar, gate codes from /api/where kept in
    memory only. Receipt parser + drafts + confirm into ChargeSessions.
2026-11-05 Hardware BOM and ESP32-P4 second screen firmware (ESPHome, compiles)
2026-11-05 Track B brain tests: receipts (4 networks), WOPR stream/primer/calendar/gate + mock WOPR, radio/ICY, Spotify tokens, FM, local, Plex, media settings, now-playing hub
2026-11-05 Track C UI: Cams view (grid/single, reverse to rear with guides, latency, save clip, clips), Truck page, settings section
2026-11-05 Track D brain: mileage log, maintenance, updater, backups, login gate, setup state
2026-11-05 Track D: tests (mileage, odometer, maintenance, updater, backups, auth, login gate); pure ops types
2026-11-05 Track C: tests (alerts, theft, viewers/sleep, go2rtc config, retention, auth), Pi deploy (go2rtc pinned, LTE, Tailscale, power-off), truck box vibration + watch UART link
    [truckbox.yaml]
2026-11-05 Track A cockpit: Drive screen, five speedometers, tilt with the configured truck, weather strip and radar view, Bel Air theme
2026-11-05 Track B cockpit: Media view (CarPlay, Spotify, radio, AM/FM, Plex, files, Apple Music), WOPR voice button + subtitle, next appointment to Waze, gate-code card, receipt confirm; settings sections
    Shared pure types in brain/src/media/types.ts so the UI never imports Node
    modules. Drive card and CarPlay strip show any source; saved layouts get the
    Media view added after CarPlay. scripts/mock-wopr.mjs stands in for WOPR on
    a desk.
2026-11-05 Track B: Pi media install (rtl-sdr, ffmpeg, librespot), contract section, roadmap, README, UI tests
2026-11-05 Track C: tier 1 watch firmware (T-SIM7080G-S3, PlatformIO, builds), truck box parked Wi-Fi off, docs (remote.md, contract, READMEs, parts list)
2026-11-05 Track D UI: Logs panel (mileage, maintenance, TPMS), Drive due card, setup wizard, settings sections, project name constant
2026-11-05 Track A: settings section for the truck and drive, contract, tests, SIM-scaled range window
2026-11-05 Track D ops: updater + backup scripts for the Pi, pi-gen image stage, release workflow, security doc, MIT license, contributing, contract and roadmap
2026-11-05 Fit the rail at 720px: Theme, Mileage & maintenance and Settings move into a More menu
    Twelve rail items overflowed after the four tracks merged. WOPR's button now
    reads WOPR when it isn't set up, not Offline.
2026-11-05 Run the cockpit in a container on a homelab server (NAS first)
    Dockerfile (Node 24 slim, ffmpeg for the desk camera fallback, tini,
    healthcheck), image built on GitHub to ghcr.io/jraben/slate-cockpit, and
    deploy/nas/docker-compose.yml on LAN port 3950 with a named data volume,
    SIM on by default and power-off disabled.
2026-11-05 Settings: seven tabs, sections fold to their titles
    The settings page had grown to about 30 sections on one scroll. It now has
    tabs (Charging & costs, Drivers & themes, Truck, Home Assistant & places,
    Media & WOPR, Cameras & remote, Logs & system); each section opens on tap.
    Links to /settings#ha, #themes, #spotify and the rest still land on the
    right tab with that section open. The save bar shows only on the tabs whose
    fields it saves.
2026-11-05 Let a /settings login open the camera and remote routes
    From another device on the LAN the Cameras & remote section answered 401:
    those routes only accepted the remote token, and the link that hands out the
    token was itself behind it. A valid admin session (password set) now counts
    too; with no password set, outside callers still need the token.
2026-11-05 My Slate: the truck customizer matches the real build, with a photo
    - Settings.truck: logo colour or none (default none, as built), interior
    colours, the slate.auto share link, the build's accessory list, a photo
    - /api/vehicle/photo: upload or fetch from https (checked, 6 MB cap),
    served to the dash; writes need the /settings login
    - Truck tab: live drawing beside the controls, Slate colour names, photo,
    share link
    - Drive: parked and level, the tilt card shows the photo; moving or steep,
    the live drawing returns. Also on /truck and in the setup wizard
    - The drawing: Toolbox Red, Clean Slate roof and wheel rings, amber
    Synthwave lamps, no body logo
    - The main Save bar no longer re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
2026-11-05 Chargers: AFDC on developer.nlr.gov, Google live stalls, what you paid (#1)
    - AFDC moved: developer.nrel.gov stopped resolving (NREL is now the
    National Laboratory of the Rockies); same API and keys at developer.nlr.gov.
    - Optional Google Places key: live free/busy/out-of-service stall counts,
    layered on the cached AFDC/OCM list. Billed, so at most one call per 5 min
    truck-wide; a count older than 30 min is shown with its age, not scored.
    - "You paid $X/kWh here" from charge_sessions (receipts, manual, detected
    with a cost), by position within 200 m or by station name + network.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
2026-11-05 Cockpit: go to the login page when the live feed is refused
    Opened from another device (the NAS copy, a phone), the cockpit showed
    "Reconnecting" for ever: /ws answers 401 until that browser logs in.
2026-11-06 Truck payoff goal from gas savings; alert on on-peak home charging
    - goal: permanent per-day ledger in cockpit.db (gas the comparison vehicle
    would have burned at that day's price, minus charging), months frozen
    once ended, explicit recalculate; target $30,740.78 editable; only real
    truck trips after the delivery date count (phone and simulated excluded);
    Charge/Drive cards, /settings ledger + CSV, HA sensors, WOPR line
    - trips and charge sessions carry 'simulated'; on a SIM brain existing rows
    are marked simulated once
    - on-peak: per-period alert switch, demand $/kW, wall-charger power entity;
    alert every 15 min while charging on-peak, 3:30pm heads-up, red banner,
    HA binary_se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
2026-11-06 Seasonal time-of-use rates; camera research
    - TOU periods take months (APS summer May-Oct, winter Nov-Apr) and their own
    demand $/kW; pricing, on-peak alerts and the 3:30 heads-up follow the
    season; Months and Demand columns on /settings
    - docs/cameras.md: three camera setups with prices, Jeff's pick, power,
    wiring and mounting rules (AHD outside, powered hub, LSE VHB on PP panels)
2026-11-06 Alerts: none from the SIM truck; miles and place names, not meters and lat/long
    - SIM: automatic alerts and maintenance reminders are logged, not pushed
    (SIM_ALERTS=1 sends them; the Test alert button still sends).
    - "Truck moved" says how far in miles and where (saved place, else
    OpenStreetMap), with no coordinates. The watch's own alert does the same and
    carries a map link for the tap.
    - Geofences: pick a saved place or search an address; radius in miles. The
    theft radius is shown in miles too. Stored values stay in meters.
2026-11-06 Service kit: slide-out brain rail, Carlinkit/hub dock, Deutsch service bracket, loom clips
    Modelled in OpenSCAD with STLs and previews. Dash rail, DT plug widths and
    Carlinkit/hub sizes are estimates; the README lists what to measure first.
    [dock.stl, dt_bracket.stl, loom_clip.stl, loom_clip_screw.stl, rail.stl, service-kit.scad]
2026-11-06 Home screen: tap-the-picture garage door, mailbox, HA tiles, arrival prompt
    - New Home view: the garage door as a picture (panels roll up; amber while
    moving; red edge on an obstruction), Open/Close/Stop and the opener light.
    Found automatically (cover.* with device_class garage).
    - The mailbox beside it, drawn like WOPR's (red = no mail yet, green =
    delivered, with the letter/package counts), from WOPR's /api/usps; tap once
    the mail is in.
    - Home Assistant tiles in pages; Edit copies one of HA's own dashboards
    (e.g. room-garage) or adds devices by search. Control is limited to the
    entities on this screen; unlocking asks first.
    - Driving home with the door closed: an "Open the ga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
2026-11-06 Parked screen: streaming apps, Plex video, games, karaoke; camp, pet, tow, light show
    - Watch: Netflix, YouTube, YouTube TV, Prime, Disney+, Max, Hulu, Peacock,
    Paramount+ open full screen in their own Chromium window on the Pi
    (deploy/pi/parked-launcher.sh runs in the kiosk session; the brain service
    has no screen) and close when the truck moves. Plex movies and shows play
    in the cockpit as HLS relayed through the brain, resuming where left off.
    - Games: Jeff's games site, Moonlight (PC games from home) and RetroArch when
    installed on the Pi. Karaoke: YouTube karaoke search; USB mic optional.
    - Camp mode: dims to a clock, runs chosen relays, cuts them below a 12V
    threshold. Pet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
2026-11-06 Main screen: the Galaxy Tab S7 FE instead of the 12.3" bar
    - Layout fits the tablet (1280x800 CSS px): shorter rail buttons so all fit,
    the clock and weather don't wrap, the place pill gives way first.
    - Installs as a full-screen Chrome app (manifest + icon).
    - On the tablet, Parked tiles open the real Android apps (intent links with
    the website as fallback); Moonlight/RetroArch open through Tasker. The
    cockpit checks in so the brain knows the tablet's address, and Tasker brings
    the cockpit back to the front when the truck moves.
    - deploy/android/README.md: setup (Chrome secure-origin flag for CarPlay USB
    and the mic, Tasker profiles), the desk test, heat.
    - Parts list, roadmap, RE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
2026-11-06 Test panel (SIM): drive by hand, fake truck events, all cameras, CarPlay sim
    More > Test panel (SIM) on a simulated truck only; every /api/sim route
    answers 404 when SIM=1 is off. Drive (gear, ignition, speed, legs),
    truck events (cabin temp, 12V, low tire, Five Switch, bump, tow-away),
    all five desk cameras live (hitch added), and a remembered CarPlay sim switch.
2026-11-07 Test panel: plug the simulated truck in to charge
    Charge tab: home 7.2 kW (60x) or DC fast 150 kW (10x, tapers past 80%),
    charge-to target, unplug, and set the level outright. The brain anchors the
    charge level every 2 points while plugged in, so the charge history logs one
    growing session and a home charge counts for the on-peak warning.
2026-11-07 Media screen: big source tiles with art; Pandora, YouTube Music, Amazon Music hand off
    - Media opens on a home of large tiles (120px art, 32px names) for Spotify,
    Pandora, YouTube Music, Amazon Music, Plex, Radio, AM/FM and Files, with
    the saved shortcuts (now bigger, with source art as fallback) below. Inside
    a source: a "Sources" back button and a 64px quick switch.
    - Original monogram/glyph SVG tile art in ui/src/media/art (not the
    services' logos).
    - CarPlay and Apple Music tabs removed (CarPlay keeps its own view).
    - Pandora, YouTube Music, Amazon Music: hand-off panes (Open CarPlay, open the
    Android app through Fully Kiosk when its JS interface is on, web player),
    showing w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
2026-11-07 Drive screen: fix the proportions, and actually show it on the tablet
    Why it looked disproportional: the tablet still had the very first default
    Drive layout (big Speed card, Battery ring, wide Next charger, tiny Trip /
    Cabin / 12V / Tilt tiles). The layout migration only recognised the second
    old default (the one with Now playing), so that layout never moved to the
    Drive screen.
    - migrateDriveLayout also upgrades the first default; a customised layout is
    still left alone. Test added.
    - Drive screen columns 1.3 / 1.1 / 0.9 (cards keep 280 px): speed and range
    lead. Each zone sizes its numbers to its own width (container units), so on
    1280x800 the range "mi" no longer spills into the c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
2026-11-07 Rail: every screen as an icon, names in the top bar, hold to rearrange
    - No more "More": Drive, CarPlay, Media, Home, Parked, Control, Charge,
    Trips, Cams, WOPR, driver, Theme, Mileage & maintenance, Test panel (SIM,
    when the brain is simulated) and Settings each get a rail icon.
    - The rail is icon-only; the current screen's name is in the top bar.
    Icons share the rail's height (42 px minimum) and the rail scrolls
    beyond that, so nothing is unreachable.
    - Press and hold an icon ~500 ms to rearrange: icons wiggle, drag with
    finger or mouse, tap outside, Escape or Done to finish; Reset restores
    the default. A tap still navigates; a slide or scroll cancels the hold.
    Holding WOPR s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
2026-11-07 Home screen: tidy up the garage card, tiles and empty states
    - Home Assistant not connected (or not answering): one card across the
    screen with an Open settings / Try again button, instead of the same red
    error in both cards.
    - Garage card: the door scales to fill the card, Open/Stop/Light sit at the
    bottom, nothing clips on the tablet (the fixed 300px door pushed the state
    tag, mailbox and Light button off the edge).
    - Mailbox: a full-width, glove-sized row under the buttons (icon, count,
    "Tap once it's brought in") instead of a small wrapped caption beside the door.
    - No garage door picked: a short note and a Settings button; the mailbox still shows.
    - Tiles: names wrap to two li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
2026-11-07 Rail order per driver profile, saved on the brain
    - Driver.railOrder (null = default) holds each driver's icon order in
    settings.json; PUT /api/drivers/:id { railOrder } saves it, null resets.
    - The brain keeps only known ids (the driver's layout views plus
    rail.ts RAIL_EXTRA_IDS), drops unknown, malformed and repeated ones,
    and refuses a non-list. Older settings files load with none.
    - The UI shows the active driver's order, saves edits to that driver
    (once a drag settles), and follows driver switches (leaving edit mode).
    localStorage keeps only the last driver's order for first paint.
    - Same reconcile rules on the stored order: new screens appended,
    removed ones dropped.
    - Test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
2026-11-07 Rename to Truck Assistant, with the voice-truck icon and lockup
    - PROJECT_NAME is now "Truck Assistant" (the strip, login, About, backups,
    mileage log and HA device follow it); the hard-coded copies (Plex product,
    HA manufacturer, page title, manifest, README, bom notice) too.
    - Icon: logo 08 (Jeff's cab, bed as a sound wave), plus a full-bleed
    maskable variant. Lockup: 07b, shown at the top of the README.
    - Top strip shows the mark + TRUCK ASSISTANT; the mark alone under 1100 px.
    - docs/brand/: the name and logo rounds (ideas, previews, all SVGs).
    - Backup test tampers a byte inside settings.json instead of a fixed
    offset that moved with the manifest's length.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
2026-11-07 Control rail icon: six live relay dots, green while a relay is on
    Two rows of three in relay order (relay_1..6, the Control grid's order):
    filled bright green with a pale ring when on, outlined when off, faint while
    the truck box is offline or hasn't reported. Tested in relayDots.test.ts.
2026-11-08 Demo cameras: loop a stock clip per camera (DEMO_FOOTAGE)
    With DEMO_FOOTAGE=<folder>, a "test" camera plays <folder>/<id>.mp4 on a
    loop instead of the ffmpeg pattern (both the desk MJPEG path and go2rtc's
    exec source), and the sim's default camera list keeps only the cameras
    that have a clip. Clips stay out of the repo.
2026-11-08 Cockpit cleanup: top bar fits, rail labels, inverter charge, truck-centred Drive
    - Top bar never cuts a word: it drops whole items, least useful first, until
    the rest fits (lib/stripFit.ts, data-fit levels in styles.css).
    - A short word under every rail icon; the current screen's icon is readable
    again (the rail's dim colour outranked aria-current).
    - The Inverter relay tile shows the truck battery it runs from: %, bar,
    range and 12V, amber at 20% or below (lib/inverter.ts).
    - Drive screen rebuilt around the truck (R1T / Taycan / EQS as inspiration):
    the side view pitches and a small rear view rolls over level lines with
    their angles, the pack shows through the body filled to the c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
2026-11-08 Control screen: estimated power per load, total, and the dash tablet
    Nothing in the truck box measures current, so each relay gets a rated wattage
    (settings relayWatts, typical defaults, editable beside the relay names) and
    the tablet gets tabletWatts. The Control screen shows ≈ watts on each load
    while it is on ("N W when on" while off), a total in W and A at 12 V, and a
    Dash tablet tile with its battery % and charging state from the browser's
    Battery API; the tablet counts only while it charges from the truck.
2026-11-08 Design-system pass, Media without scrolling, house cameras on Home
    Design tokens (ui/src/styles.css): 8pt spacing, one 12px radius for
    everything tappable (16px for panels), hero/section/body/caption type roles,
    7% hairline edges instead of hard lines, 44px minimum tap targets, 200 ms
    hover and press feedback. Night and Day retuned to muted slate with a calmer
    teal; Inter is the body font in every theme; all presets pass 4.5:1.
    Screens: charger rows (score badge, full name, Waze arrow button), panel
    headers that wrap instead of squashing, icons on the Control tiles, a
    stacked next-appointment card, two-line song titles. Media's sources are a
    launcher grid and Saved is compact rows, so the p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
2026-11-08 Power ring speedometer with a scene per theme
    The default Drive speedometer is now a ring: speed in the middle, power out
    clockwise and regen anticlockwise (estimated from speed and acceleration until
    the CAN bus reports kW). Inside it, an animated scene drawn in the theme's own
    colours; the road, grid and gears move at the truck's speed.
2026-11-09 SIM drives real Phoenix streets; the truck on a God's Eye View globe
    The simulated truck's loop was three legs of 5-6 hand-placed points joined by
    straight lines. It now follows real roads: scripts/bake-sim-roads.mjs routes
    each leg with OpenStreetMap routing (OSRM on the FOSSGIS servers, the ones
    God's Eye View's Directions uses) and writes brain/src/simRoads.ts, which is
    committed so the brain never calls the router. The loop drives each road's own
    speed, brakes into corners, and keeps its red lights off the freeway.
    /globe/aircraft.json serves the truck as one ground vehicle in dump1090's
    aircraft.json form, so God's Eye View's Local ADS-B layer
    (LOCAL_RECEIVER_FEEDS) draws it, tracks it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
2026-11-09 Road trip planner, charging coach, trip costs, and a choice of assistant
    Road trips: a Road trip screen plans the fastest charging stops along an OSRM
    route (energy from speed, heat and Open-Meteo elevation), with how much to
    charge at each stop, when to leave, a backup for each, the estimated charging
    cost, a gas comparison and drive vs charge time. The charging curve starts
    generic and is learned from the truck's own DC charging; slow sites are
    remembered. On the trip: a live stall check before each stop with a switch to
    the backup when it's full, a replan when the truck uses more than planned, and
    a charging coach (countdown, GO, slow-stall warning). Demo: Flagstaff, Tucson,
    Los Angeles a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
2026-11-09 Traffic: 511 cameras and incidents ahead, enforcement cameras
    A Traffic screen shows state 511 traffic cameras ahead (along the trip route,
    else the way the truck is heading, else nearby when parked), crashes, closures
    and roadwork ahead, and speed / red-light camera locations from OpenStreetMap,
    with a banner for a crash or closure close ahead or a camera coming up. The
    truck fetches each state's feed itself with that state's free developer key
    (settings page), within the ten-calls-a-minute limit. Arizona and Wisconsin are
    confirmed; Utah, Nevada, Idaho, Georgia, Louisiana, Alaska and Ontario use the
    same platform. Demo mode has an invented AZ511 feed along the simulated drive.
    Co-Authored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
2026-11-09 Road trips: stops along the way; traffic pictures pause while driving
    Saved places now say what they are (restaurant, friend, hotel, home, work,
    other), whether you can charge there and a note. A road trip can route through
    up to eight of them: each leg is planned on its own, the truck waits each stay,
    charging during a stay counts (a night on Level 2 at a friend's), and a fast
    charger beside a stop can be used when leaving it. The Road trip screen adds
    Go / + Stop on every place, editable stays, and saving a searched address as a
    place. Traffic camera pictures pause above the driving lockout speed, like video.
2026-11-09 Contacts sync, airport pickup, hazards ahead, camp sky, God's Eye scenes
    Contacts: Outlook (device-code sign-in), Google (People API) and CardDAV
    (iCloud, Fastmail, Nextcloud) address books synced every 30 minutes; changed
    addresses are looked up again, removed contacts go. Located contacts become
    Road trip destinations and stops with call buttons (tel: on the tablet, or a
    tap-to-call notification on the phone).
    Airport pickup: a flight followed live by ADS-B (adsb.fi, adsbdb), landing and
    leave times from distance, speed and the drive, phone alerts at leave now /
    landed / at the gate, and a suggestion from the next calendar event.
    Hazards: NWS warnings and the forecast for the hour the tr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
2026-11-09 HD Radio: HD1-HD4 and song titles, on the truck tuner or an nrsc5-webplayer
    - Truck tuner: nrsc5 -t raw -o - | ffmpeg, with station, song, sub-channel
    types and signal read from nrsc5's log. No --dump-aas-files: nrsc5 writes
    those under names the broadcast picks, unchecked.
    - Remote nrsc5-webplayer (github.com/wryandginger/nrsc5-webplayer): the brain
    tunes it, relays its stream and album art, reads its /status.
    - AM/FM tab: HD1-HD4 buttons, live song line, HD presets, an HD Radio server
    source; Auto goes tuner, then the server if it answers, then streams.
    - Pi installer builds nrsc5 v3.2.0 (pinned); a failed build leaves analog FM.
    - Demo: an invented HD Radio server with two presets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
2026-11-09 HD Radio: fall back to analog when HD1 is lost, and find HD stations
    On the truck's tuner, HD1 switches to the station's analog signal on the
    same stream when nrsc5 can't lock (15 s) or loses lock (8 s), tries HD
    again at 2 and 10 minutes, then on "Back to HD". HD2-HD4 never fall back.
    "Check presets" / "Scan the band" listen to each FM frequency with nrsc5
    and list which carry HD and what's on HD2-HD4.
    FmService takes injectable spawn/which/now, so the new tests drive it with
    fake processes (no dongle).
2026-11-09 Driver photos, and automatic updates while parked
    Driver photos: each driver can have a picture (Settings > Drivers), cropped
    and shrunk to a 256 px JPEG on the device, stored as
    DATA_DIR/driver-photos/<id>.<ext>, shown instead of the initials on the rail
    and driver picker. Behind the login from other devices; deleted with the
    driver; included in backups.
    Automatic updates: GitHub is checked every 12 hours (was 6). With "Install
    updates automatically" on, a new version installs by itself only when not
    driving (ignition off, no trip, not moving), optionally only on home Wi-Fi.
    A version an automatic install already tried isn't retried by itself.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
2026-11-09 Trip energy review: power used and regenerated on a map and chart
    Trips > a trip > Energy, for looking back after a drive (never live):
    used / regenerated / net, Wh/mi, climb and descent, peaks; the route on a
    map coloured by power; height, speed and power against distance with a
    scrub that moves a marker on the map; where the energy went; driving vs
    the dash's tech vs switched accessories; and the trip's load.
    Every ~2 s of a truck trip goes into trip_samples (GPS height, speed, pack
    power when the truck box sends sensor/pack_power_kw, estimated tech and
    accessory watts), never thinned. Without pack power the figures come from
    a physics model (Settings > Trip energy model) and are labelled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
2026-11-09 Measured 12 V power: optional INA226 sensors on the truck box
    firmware/truckbox/packages/power_ina226.yaml: one include per circuit
    (name, I2C address, shunt) publishes sensor/relay_N_w (+ _a) or
    sensor/dash_w for the dash electronics' feed. README "Measured power" has
    the wiring, shunt sizing and addresses (avoiding the SHT31's 0x44/0x45).
    The brain keeps measured watts per relay and for the dash (cleared when the
    truck box goes offline) and uses them wherever present, rated watts
    elsewhere: the Control screen shows measured loads without the ≈ (and
    "nothing drawing" for a relay that's on at 0 W) plus a Dash electronics
    tile, and trip samples record whether tech and accessories were meas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
    [truckbox.yaml]
2026-11-10 Tablet as GPS, and God's Eye chase export
    The dash tablet can be the truck's GPS: the dash page sends the tablet's
    location over the socket (at most once a second), and the brain uses it
    whenever no GPS puck has had a fix in the last 5 s. Accepted only from an
    Android browser on a private or Tailscale address, with Settings > Truck >
    "Use the dash tablet's GPS" on (default). Accuracy worse than 100 m moves
    the map but is not a fix. Health reads 'tablet' while it is the source.
    SIM test panel: "Use this browser's location" desk test
    (POST /api/sim/gps-device). Setup (Chrome flag for the http dash) in
    deploy/android/README.md step 8.
    God's Eye export: flyAlong now builds a chase camera, dista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
2026-11-10 Tablet sleep settings: when the dash tablet sleeps after the truck turns off
    Settings > Truck > "Dash tablet when the truck turns off": sleep the screen
    after N minutes (default 2, 0 = right away), or keep it on until its battery
    is down to N %. Tasker's "Truck off" task reads GET /api/tablet/sleep when
    the power drops (open: Tasker can't log in; GET/HEAD of that one path only)
    and falls back to 2 minutes if the brain doesn't answer; "Truck on" stops
    the task. Setup in deploy/android/README.md step 6.
2026-11-10 Install guides: desk and truck, step by step with pictures
    docs/install/desk.md: the software on a computer with a simulated truck,
    the dash tablet (Chrome flag, CarPlay through the hub, Tasker), the Pi on
    a bench with a toggle-switch ignition, flashing the truck box, sign-off.
    docs/install/truck.md: safety, finding constant and switched 12 V with a
    meter, add-a-circuit taps, fuse block, brain under the dash, tablet,
    truck box, cameras, first power-up, calibration, test drive, unknowns.
    Screenshots and diagrams in docs/install/img/; README links both.
2026-11-10 Rail fits short screens: no icons cut off in a tablet browser
    Chrome with its tab strip and address bar, plus Samsung's taskbar, leaves
    the page 570-620 px tall; 16 rail buttons at a 44 px minimum ran past the
    bottom (Cams and below scrolled away, labels clipped). Under 700 px tall
    the icons and labels shrink; under 560 px the labels go. The bigger icons
    while driving no longer override it. Measured at 1280x800 down to 960x540.
2026-11-10 UI cleanup on design tokens: 8pt spacing, type roles, 12px radius, 44px targets
    - Spacing, font sizes and radii across the UI now use the :root tokens
    (8pt grid, hero/display/title/section/body/caption roles, one 12px radius).
    - Pure black behind video and camp mode is a muted near-black (--media-bg).
    - 200ms hover lift (scale 1.01, mouse only) and press shrink on everything tappable.
    - Traffic, pickup and road-trip banners stack top-right under the strip
    instead of covering it.
    - Short screens get a two-column rail of 44px icon buttons, nothing cut off.
    - Pickup: no negative "out front in -N min"; the banner clears 30 min after
    the passenger should be out front.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
2026-11-10 Health icons in the strip; Drive's now playing follows any source
    - Brain, truck box, GPS and network are one strip button: a four-segment
    gauge and brain / Raspberry Pi / GPS / Wi-Fi icons, green fine, red not,
    grey when unknown. Tap for a plain-words panel; its network row opens
    the network picker (NetPill removed).
    - The Drive screen's Now playing card used CarPlay only; it now shows the
    same pick as the Media tab (radio, FM, Plex, Spotify, files, CarPlay).
2026-11-11 "Who's driving?" pop-up is a setting, off by default, with "Don't ask again"
    - New setting askDriver (default false). Off: the ignition never pops up a
    prompt; exactly one driver's phone at the truck (HA) switches to them
    quietly, otherwise the last driver stays. The rail's driver badge still
    picks a driver any time.
    - On: the prompt as before, plus a "Don't ask again" box that turns the
    setting off when a driver is picked.
    - Settings checkbox beside the tablet GPS option; contract documents it.
2026-11-11 Website for truck-assistant.com on GitHub Pages
    site/ is a one-page landing site in the app's tokens: what it is, the demo,
    screens, how it works, how to build one (with "coming soon" slots for
    printed parts and parts kits), and the not-affiliated notice. site/build.mjs
    copies the screenshots it uses from docs/ and ui/public/ into _site;
    .github/workflows/pages.yml builds and publishes it.
2026-11-11 Drive: payoff and since-charge cards back; Cams tiles fit the feed; photo errors show
    - Drive shows up to three cards: moving = now playing, since charge, the
    truck-payoff gas savings; parked = since charge, payoff, now playing. The
    trip card fills an empty slot. The payoff card shows as soon as there is a
    goal, not only once counting has started.
    - Cams grid: each tile takes the feed's 16:9 shape as large as its cell
    allows and the picture fills it. Three cameras sit two on top, one centred
    below (were four narrow columns with black bands).
    - Driver photo: the result (or the error) shows next to the photo button.
    It used to appear by Save at the bottom of the form, so a failed u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
2026-11-11 Cams: an old four-tile Cams layout becomes the grid view
    Profiles saved before the grid view kept four separate camera tiles
    (Rear, Bed, Front, Hitch) three columns wide, so each 16:9 feed sat in a
    tall black tile and the fixed grid never applied. A Cams view that is
    exactly that old default now loads as the grid view; a customised one is
    left alone.
2026-11-12 God's Eye chase: space shots along the road, not on GPS fixes
    On a long straight the trip's GPS fixes can be miles apart. The chase
    snapped each shot to the first fix past its distance, so several shots
    landed on one spot: the camera stopped for a few legs, then jumped
    (Phoenix demo trip: fly-3..fly-6 identical, then 2.5 mi in one leg).
    Each shot is now the point at that distance between fixes, elevation
    interpolated, so the pace is steady.
2026-11-12 Dash: missed charges, honest FM banner, due wording, pickup + low-tire banners
    - Since charge: more than a full pack's worth of miles since the last logged
    charge says a charge wasn't logged, instead of "~1234% used".
    - Media: on a hotspot with save-data, the banner no longer promises AM/FM uses
    no data when there is no tuner and it streams.
    - Maintenance: a due item names only what is overdue ("500 mi overdue", not
    "... overdue · in 31 days").
    - Range card: no "0 mph avg" when parked.
    - Traffic: with no 511 cameras ahead, the road-ahead list gets the room.
    - Pickup banner shows the whole time a pickup is on, not only at leave-now.
    - A low tire (under 30 psi, the phone alert's default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
2026-11-12 Banners: most urgent in full, the rest one line; video scripts in scripts/video
    - Several banners at once no longer stack down over the right-hand cards:
    they are ordered by urgency (low tire, traffic, road trip, on-peak,
    pickup) and only the first is shown in full; the others are one line
    each, still tappable.
    - scripts/video: how the God's Eye drive video is made (globe-chase.mjs
    renders the chase scene frame by frame, record-dash.mjs records the demo
    dash with features at set miles, compose.mjs syncs them by position and
    captions them). God's Eye's address comes from GEV_URL. README covers the
    Google 3D Tiles caveat before posting publicly.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
2026-11-12 Traccar feed: the truck on the home GPS map beside the other vehicles
    OsmAnd reports to TRACCAR_URL (off unless set, never under DEMO): every
    30 s while on or moving, every 10 min parked, with speed, heading,
    battery, range, ignition and 12 V as attributes. A failed post is
    dropped, not queued (the truck has no modem).
2026-11-13 Passenger mode: let a passenger use the tablet while driving (#1)
    Tap anything the driving lockout paused (video, the browser, long lists,
    typing, Watch/Games/Karaoke, traffic camera pictures) and it asks "Are you
    the passenger?"; yes turns passenger mode on until the next startup. Also a
    switch in Settings, Truck, and a Passenger pill in the top bar that turns it
    off with one tap.
    lockout.locked keeps meaning "moving": camp/pet mode still end, the light
    strip still goes off and the Lights tab stays parked only. New
    lockout.passenger flag; POST /api/drive/passenger {on}. Not saved, so a
    brain restart turns it off.
    Claude-Session: https://claude.ai/code/session_01RVxtSRX77fXuWDGyTnyUtU
    Co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
2026-11-13 Offline maps: download areas to the Pi, and a Map view that works with no signal (#2)
    Settings, Truck, Offline maps: frame an area on a map (or take 10/25/50 mi
    around the truck), pick the detail, and the brain downloads it from
    Protomaps' daily OpenStreetMap build with merged HTTP range requests into
    DATA_DIR/maps.db. Progress, retry, update to the newest map, delete (keeping
    tiles another area shares), an on/off switch, disk-space and size checks;
    an unfinished download resumes at the next start.
    The new Map view follows the truck and says whether it's inside an offline
    area; it and the trip energy map draw downloaded areas from the Pi over the
    online OpenStreetMap layer, so they keep wor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
2026-11-13 Offline navigation: every Navigate button offers Organic Maps on the tablet (#3)
    Charge stops, road-trip stops, the airport pickup and calendar appointments
    open one Navigate window: Waze (iPhone and CarPlay, needs signal) as before,
    or Organic Maps on the dash tablet, which navigates with no signal in states
    downloaded inside it. On Android it opens as an intent with a route from the
    truck's GPS fix, falling back to the Play Store; elsewhere a QR code.
    Settings, Truck, Navigation: which app opens first on this screen (automatic
    picks Organic Maps when the truck has no internet), and Organic Maps setup.
    Co-authored-b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
2026-11-13 Sim: stop and charge itself at 0%; at-speed rail no longer flickers (#4)
    At 0% the simulated truck kept driving its loop on an empty battery: the
    charge level sat at 0 while miles since the last charge climbed past a
    thousand. Now it coasts to a stop, plugs into a DC fast charger by itself,
    charges to 80% (logged as a session, so since-charge resets) and the loop
    carries on. The Test panel says when that happened.
    The rail's parked-only buttons (theme, logs, test, settings) hid at 25 mph
    and came back under it, and town speeds hover around 25 and drop to 0 at
    lights, so they came and went every few seconds. Now on at 25, off only
    after 15 s at or under 15 mph.
    Claude-Session: https://clau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
2026-11-13 While driving: a Passenger? button in the top bar, and the SIM Test panel stays reachable (#5)
    * Passenger mode: a Passenger? button in the top bar while driving
    Settings steps aside at speed, so a passenger had no way in unless something
    paused was already on screen. While moving with passenger mode off, the top
    bar now shows an outlined Passenger? button that asks and turns it on; once
    on, it becomes the solid Passenger button that turns it off.
    * Test panel stays on the rail at speed in SIM, so the simulated truck can be stopped
    It was parked-only like Settin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
2026-11-13 Brain box: the Truck Assistant logo on the lid, in colour (#9)
    * Brain box: the Truck Assistant logo engraved in the lid
    The glyph (the truck's profile line and wheel rings, drawn in OpenSCAD from
    docs/brand/truck-assistant/logo-06-glyph.svg, since SVG import drops strokes)
    beside the fan, and TRUCK ASSISTANT between the vents and the fan, 0.6 mm
    into the top face. That face prints on the bed, so no supports. logo = false
    leaves the lid plain. Re-exported lid.stl and the previews; added lid.png.
    * Brain box logo in colour: red and white inlay parts for a multi-co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
    [brain-enclosure.scad, lid.stl, logo_red.stl, logo_white.stl]
2026-11-13 Rail: parked-only tools stay at speed and ask "Are you the passenger?"; profile pinned to the bottom (#10)
    At 25 mph and over, Theme, Logs and Settings used to leave the rail. Now they
    stay, dimmed while driving; tapping one asks "Are you the passenger?", and
    yes turns passenger mode on and opens it. The rail no longer jumps, and the
    oversized at-speed rail icons that only fitted with four buttons gone are
    dropped. The driver's profile always sits last on the rail and is sticky at
    its foot, so it shows even when the rail scrolls.
    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
2026-11-13 Rail: 15 icons instead of 18. Theme in the profile, logs on Trips, Traffic in Map (#12)
    Theme moves into the driver's panel (Theme…), since themes are per driver.
    The mileage and maintenance logs open from the Trips header (and the Drive
    screen's due card, as before). Traffic becomes a tab on the Map screen; a
    layout's standard Traffic view leaves the rail, a customised one stays, and
    traffic alerts and #traffic links open the Map's Traffic tab. The rail now fits
    the 1280x800 tablet without scrolling.
    Also: 'map' joins the brain's known rail ids (a dragged Map icon's position was
    being dropped when saved), and a stable-channel check with no releases says to
    switch to main.
    Claude-Sessio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
2026-11-14 NAS updates itself: an updater container pulls each new build from main (#14)
    deploy/nas/docker-compose.yml gains an updater service (docker:27-cli with the
    Docker socket) running auto-update.sh: every 10 minutes it pulls
    ghcr.io/jraben/truck-assistant:latest, which GitHub pushes only after a green
    build, and if the image changed, restarts the cockpit on it, going back to the
    previous image if the new one isn't healthy within 3 minutes. On the NAS's
    bridge network, like the cockpit.
    The image now carries release.json with its commit and build time, so the
    version line and Settings, Updates show which build is running, and the
    Updates card says a Docker copy updates itself (UPDATES_BY=docker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
